Ironman-007/HexSense_Svalbard/README.md

# HexSense_Svalbard

The HexSense sensor node design for Svalbard mission in July, 2023
