Ironman-007/HexSense_Svalbard/Mechanical/bottom_Cap.SLDPRT

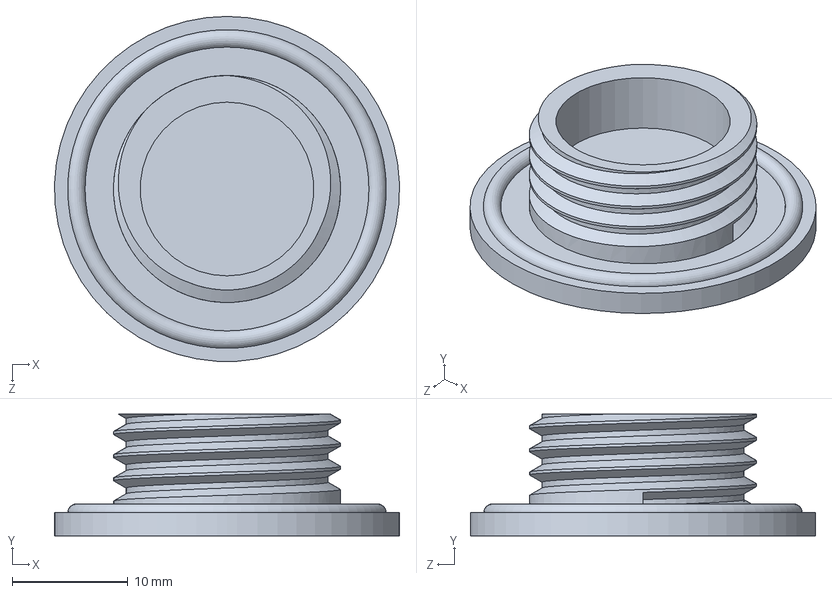
[picture p1: CAD file, 2023-06-30]
Mechanical/bottom_Cap.SLDPRT
29.8 x 10.5 x 29.8 mm
