Ironman-007/HexSense_Svalbard/PCB/Side_PCB.dxf

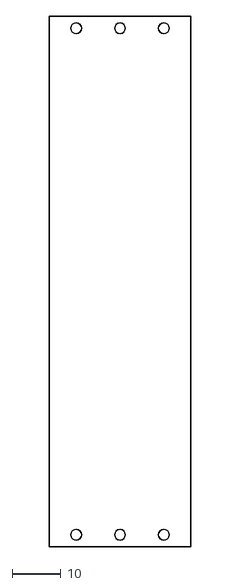
[picture p2: CAD file, 2023-06-01]
PCB/Side_PCB.dxf
29.0 x 109.0
