Ironman-007/HexSense_Svalbard/PCB/TOPBOARD/V1/TOPBOARD.step

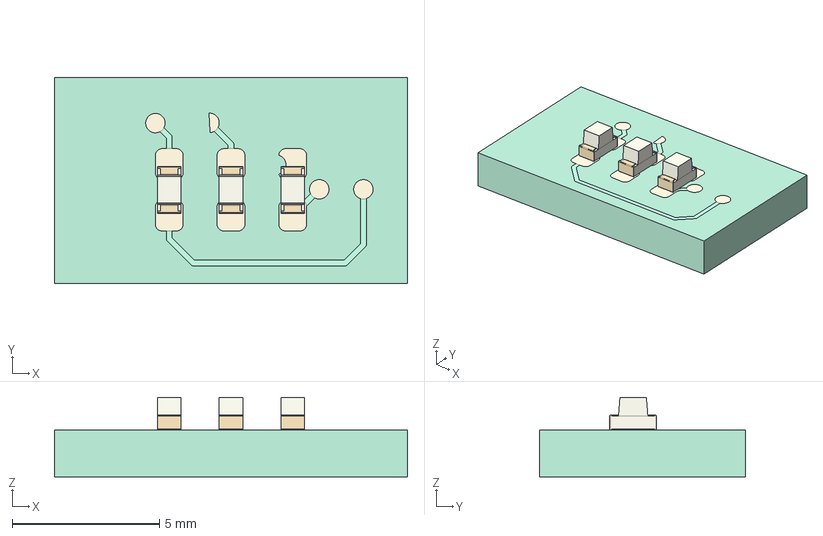
[picture p3: CAD file, 2023-06-09]
PCB/TOPBOARD/V1/TOPBOARD.step
12.0 x 7.00 x 2.72 mm
Local_CS_4601
Pcb_4601
PCB_Sketch_4601
topPads_4601_cut
topTracks_4601
botPads_4601
botTracks_4601
D2_LED_0603_1608Metric_e1ccf86073a2 x 3
