Ironman-007/HexSense_Svalbard/Mechanical/cap.SLDPRT

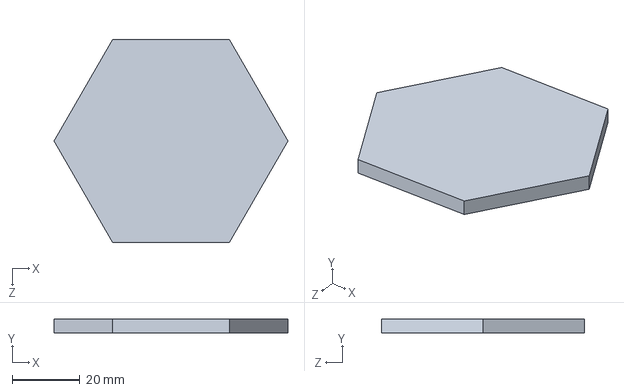
[picture p4: CAD file, 2023-06-30]
Mechanical/cap.SLDPRT
69.3 x 4.00 x 60.0 mm
