Ironman-007/HexSense_Svalbard/PCB/Frame.dxf

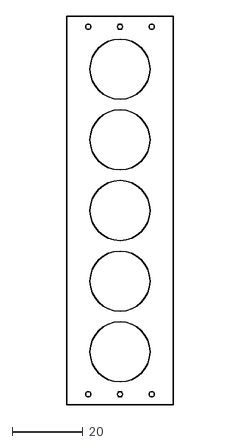
[picture p5: CAD file, 2023-06-01]
PCB/Frame.dxf
30.0 x 110.0
