Ironman-007/HexSense_Svalbard/Mechanical/scharging_port_opner.SLDPRT

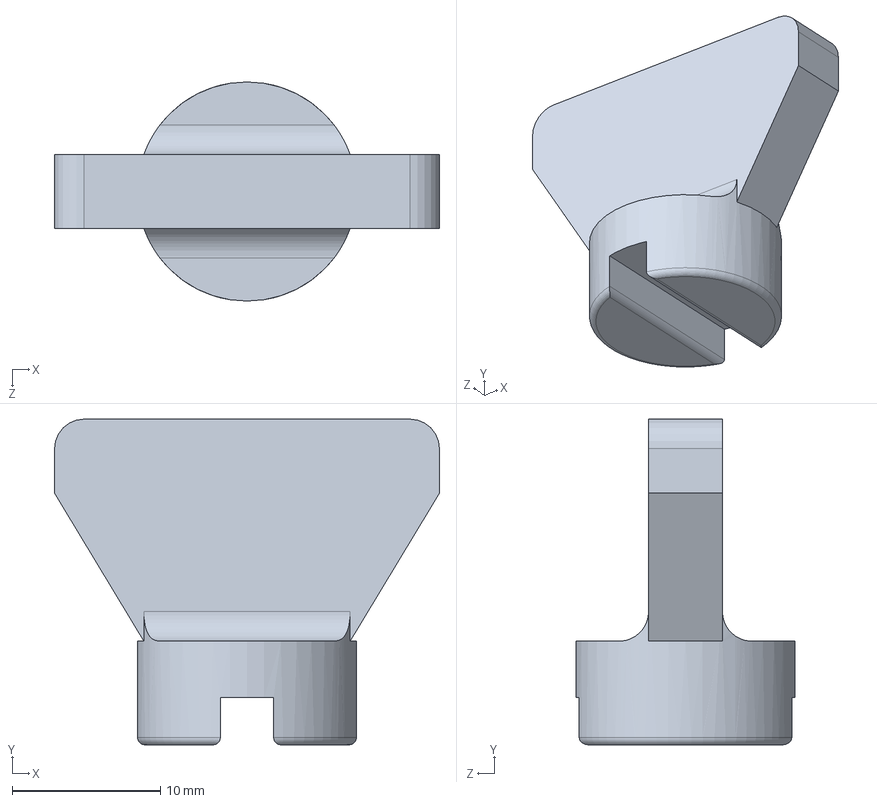
[picture p6: CAD file, 2023-06-30]
Mechanical/scharging_port_opner.SLDPRT
26.0 x 22.0 x 14.8 mm
