Ironman-007/HexSense_Svalbard/PCB/HexSense_Svalbard_internal_PCB_shape.dxf

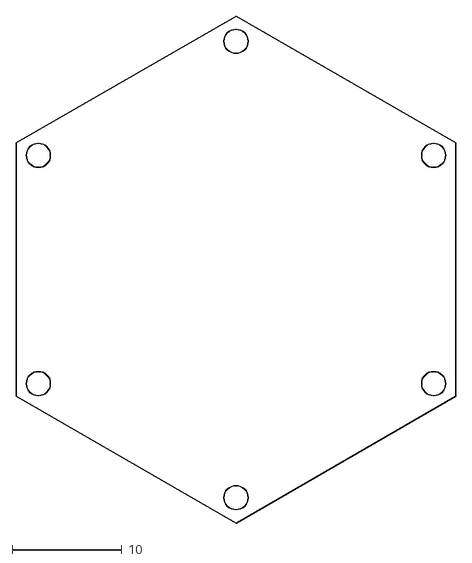
[picture p7: CAD file, 2023-05-29]
PCB/HexSense_Svalbard_internal_PCB_shape.dxf
40.0 x 46.2
