Ironman-007/HexSense_Svalbard/PCB/SIDE/V1/SIDE.step

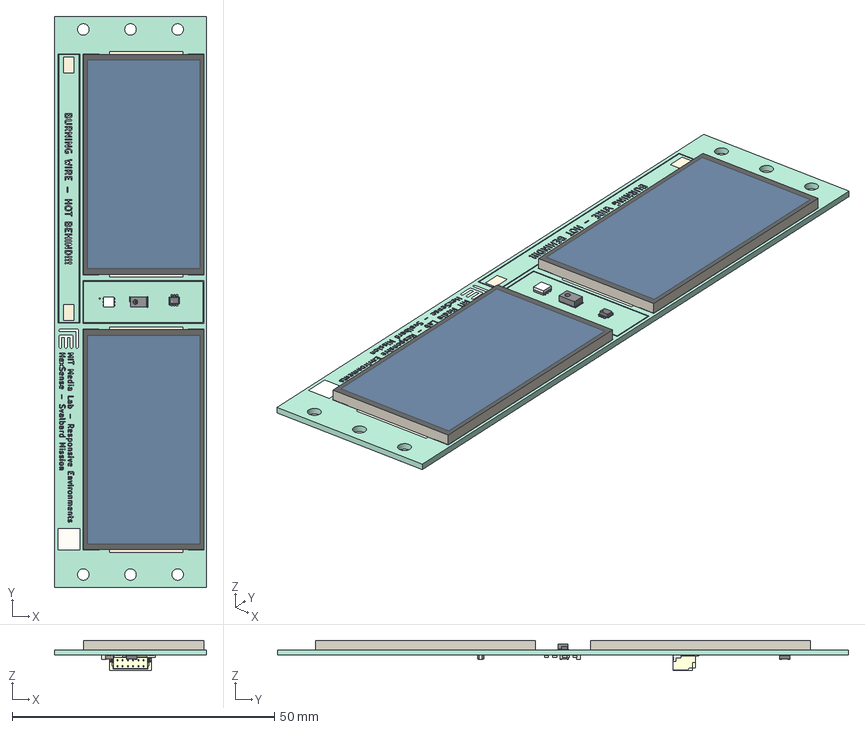
[picture p8: CAD file, 2023-06-01, an earlier design]
PCB/SIDE/V1/SIDE.step
29.0 x 109.0 x 5.76 mm
Local_CS_b4b2
Pcb_b4b2
PCB_Sketch_b4b2
topPads_b4b2_cut
botPads_b4b2
topSilks_87f0
SC2_Part 1_4863a58bc153 x 2
AS7341-DLGT
AS7341-DLGT001
AS7341-DLGT002
AS7341-DLGT003
AS7341-DLGT004
AS7341-DLGT005
AS7341-DLGT006
AS7341-DLGT007
AS7341-DLGT008
AS7341-DLGT009
AS7341-DLGT010
AS7341-DLGT011
AS7341-DLGT012
AS7341-DLGT013
AS7341-DLGT014
AS7341-DLGT015
AS7341-DLGT016
AS7341-DLGT017
AS7341-DLGT018
AS7341-DLGT019
AS7341-DLGT020
AS7341-DLGT021
AS7341-DLGT022
AS7341-DLGT023
AS7341-DLGT024
AS7341-DLGT025
U2_SOT_563_8ebe2970b71a
VEML6030
VEML6031
VEML6032
VEML6033
VEML6034
VEML6035
VEML6036
VEML6037
R5_R_0603_1608Metric_20d752b8e786 x 6
C2_C_0603_1608Metric_8d6b961ed3ee x 2
D1_D_0805_c4761f91ea4f x 2
SM06B-SRSS-TB(LF)(SN)
SM06B-SRSS-TB(LF)(SN)001
SM06B-SRSS-TB(LF)(SN)002
SM06B-SRSS-TB(LF)(SN)003
SM06B-SRSS-TB(LF)(SN)004
SM06B-SRSS-TB(LF)(SN)005
SM06B-SRSS-TB(LF)(SN)006
SM06B-SRSS-TB(LF)(SN)007
SM06B-SRSS-TB(LF)(SN)008
