Ironman-007/HexSense_Svalbard/(list of files, cad)

Other CAD files:
PCB/DATA_STORAGE/V1/DATA_STORAGE-F_Silkscreen.dxf
PCB/DATA_STORAGE/V2/DATA_STORAGE-F_Silkscreen.dxf
PCB/MCU/MCU-F_Silkscreen.dxf
PCB/PWR/V1/PWR-F_Silkscreen.dxf
PCB/PWR/V2/PWR-F_Silkscreen.dxf
PCB/SIDE/V1/SIDE-F_Silkscreen.dxf
PCB/SIDE/V2/SIDE-F_Silkscreen.dxf
PCB/SIDE/V3/SIDE-F_Silkscreen.dxf
