Ironman-007/HexSense_Svalbard/PCB/BURNING_R/V1/BURNING_R.kicad_pcb

## KiCad design PCB/BURNING_R/V1/BURNING_R.kicad_pcb (2023-06-27)

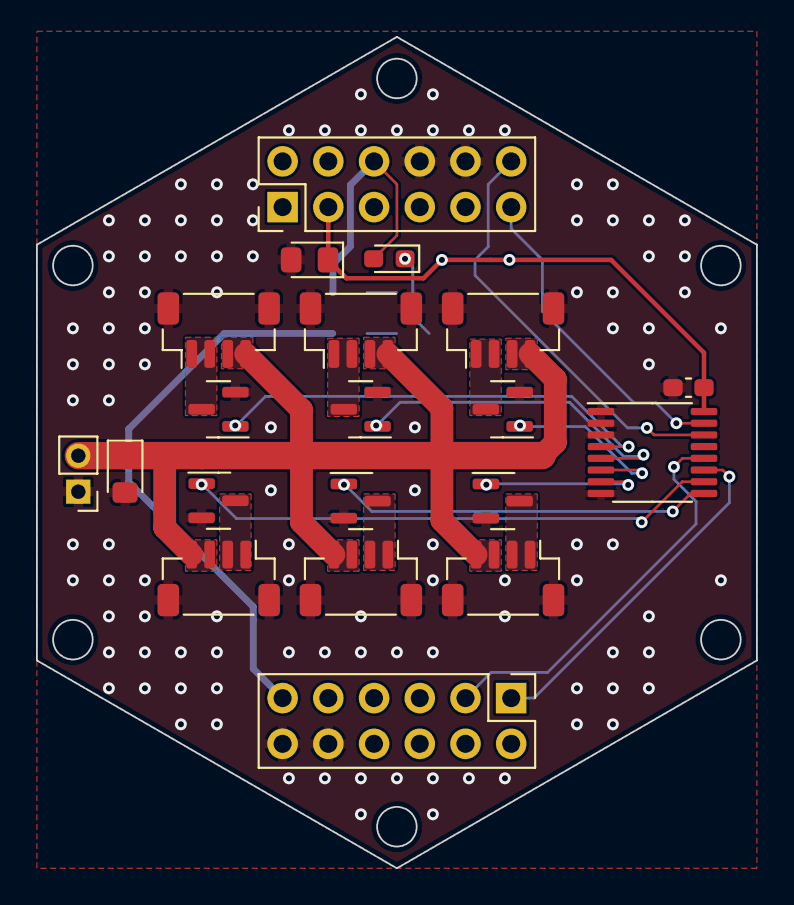
[picture p9: board BURNING_R.kicad_pcb from above]

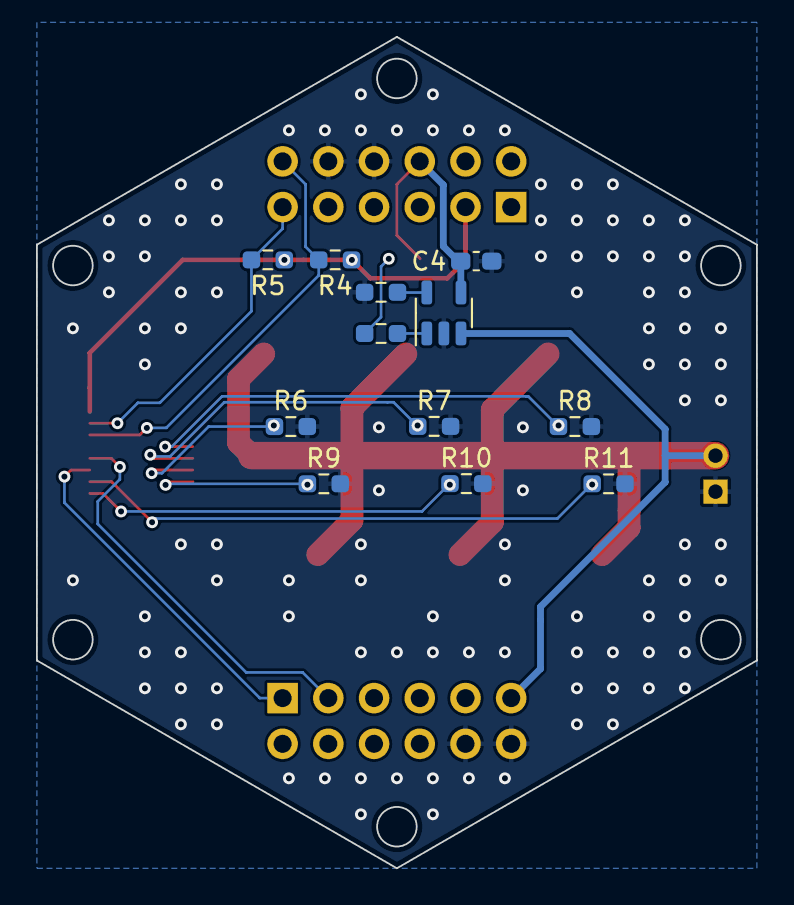
[picture p10: board BURNING_R.kicad_pcb from below]

Board: 2 copper layers, 40.0 x 46.2 mm, 32 parts (12 on the bottom side), 23 nets.

Parts:
C1, C3: 47uF; LED_0805_2012Metric_Pad1.15x1.40mm_HandSolder
C2, C4: 0.1uF; C_0603_1608Metric_Pad1.08x0.95mm_HandSolder
D1: RED; LED_0603_1608Metric_Pad1.05x0.95mm_HandSolder
J1, J2: Conn_02x06_Odd_Even; PinHeader_2x06_P2.54mm_Vertical
J3, J4, J5, J6, J7, J8: BR_conn; JST_SH_BM04B-SRSS-TB_1x04-1MP_P1.00mm_Vertical
J9: Battery; PinHeader_1x02_P2.00mm_Vertical
Q1, Q2, Q3, Q4, Q5, Q6: DMN2056U; SOT-23
R1, R2: 1k; R_0603_1608Metric_Pad0.98x0.95mm_HandSolder
R4, R5: NC; R_0603_1608Metric_Pad0.98x0.95mm_HandSolder
R6, R7, R8, R9, R10, R11: 10k; R_0603_1608Metric_Pad0.98x0.95mm_HandSolder
U1: TCA9534; TSSOP-16_4.4x5mm_P0.65mm
U2: MCP73831-2-OT; SOT-23-5

Connections:
+5V: C4.1, D1.2 (A), J1.6, U2.4 (VDD)
/BAT_BR: C3.1, J2.11, J3.3, J3.4, J4.3, J4.4, J5.3, J5.4, J6.3, J6.4, J7.3, J7.4, J8.3, J8.4, J9.2, U2.3 (VBAT)
/BR_1: J3.1, J3.2, Q1.3 (D)
/BR_1_EN: Q1.1 (G), R11.1, U1.10 (P5)
/BR_2: J4.1, J4.2, Q2.3 (D)
/BR_2_EN: Q2.1 (G), R10.1, U1.9 (P4)
/BR_3: J5.1, J5.2, Q3.3 (D)
/BR_3_EN: Q3.1 (G), R9.1, U1.7 (P3)
/BR_4: J6.1, J6.2, Q4.3 (D)
/BR_4_EN: Q4.1 (G), R8.1, U1.4 (P0)
/BR_5: J7.1, J7.2, Q5.3 (D)
/BR_5_EN: Q5.1 (G), R7.1, U1.5 (P1)
/BR_6: J8.1, J8.2, Q6.3 (D)
/BR_6_EN: Q6.1 (G), R6.1, U1.6 (P2)
/P1: J2.1, U1.11 (P6)
/P2: J2.3, U1.12 (P7)
/SCL: J1.12, R4.2, U1.14 (SCL)
/SDA: J1.11, R5.2, U1.15 (SDA)
GND: C1.2, C2.2, C3.2, C4.2, J1.8, J1.10, J2.10, J2.12, J3.MP, J4.MP, J5.MP, J6.MP, J7.MP, J8.MP, J9.1, Q1.2 (S), Q2.2 (S), Q3.2 (S), Q4.2 (S), Q5.2 (S), Q6.2 (S), R1.1, R6.2, R7.2, R8.2, R9.2, R10.2, R11.2, U1.1 (A0), U1.2 (A1), U1.3 (A2), U1.8 (GND), U2.2 (VSS)
unnamed: D1.1 (K), R2.2
unnamed: R1.2, U2.5 (PROG)
unnamed: R2.1, U2.1 (STAT)
VCC: C1.1, C2.1, J1.3, R4.1, R5.1, U1.16 (VDD)
