Ironman-007/HexSense_Svalbard/PCB/MCU/MCU.kicad_pcb

## KiCad design PCB/MCU/MCU.kicad_pcb (2023-06-27)

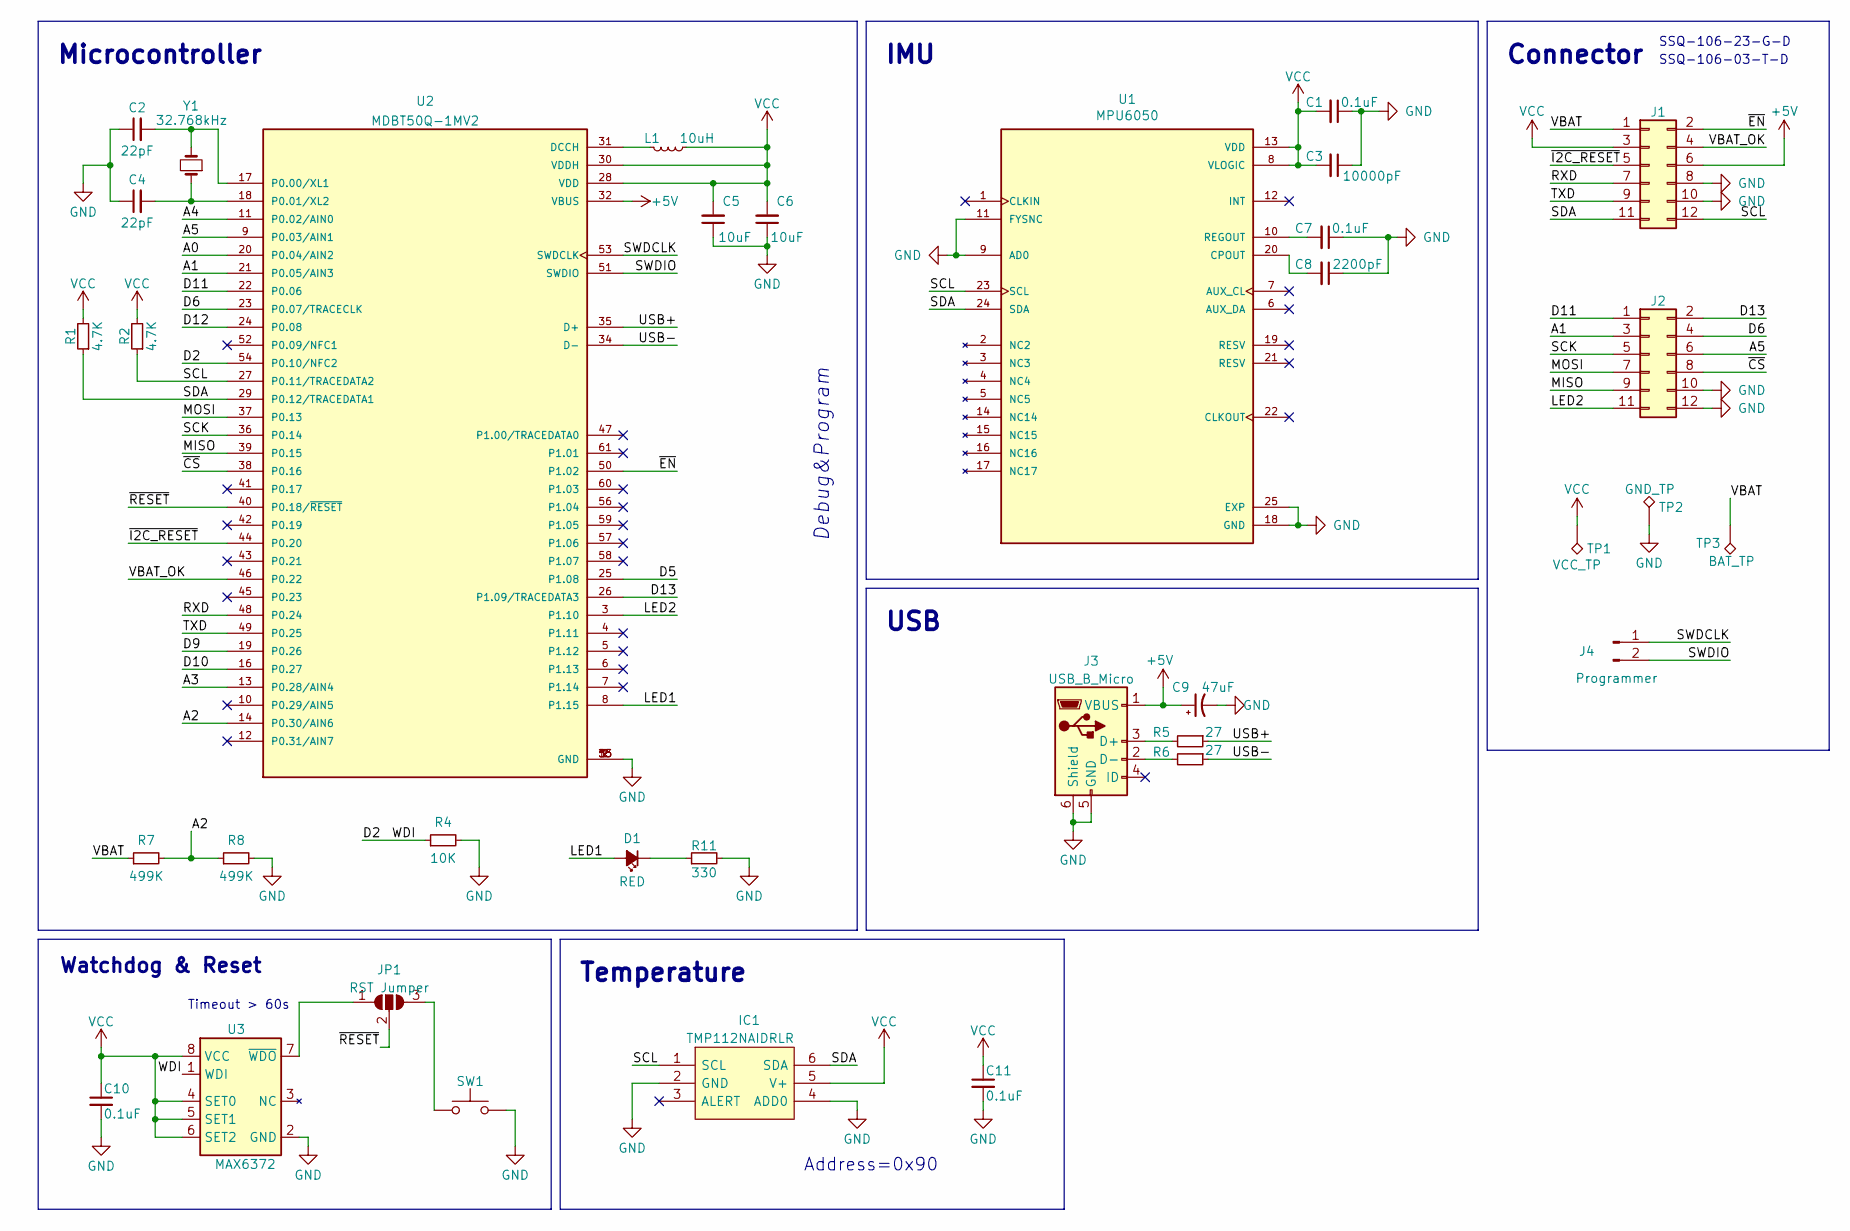
[picture p11: schematic MCU.kicad_sch, HexSense Svalbard - MCU module]

Parts:
C1, C7, C10, C11: 0.1uF; C_0402_1005Metric
C2, C4: 22pF; C_0402_1005Metric_Pad0.74x0.62mm_HandSolder
C3: 10000pF; C_0402_1005Metric
C5, C6: 10uF; C_0402_1005Metric_Pad0.74x0.62mm_HandSolder
C8: 2200pF; C_0402_1005Metric
C9: 47uF; C_0805_2012Metric_Pad1.18x1.45mm_HandSolder
D1: RED; LED_0603_1608Metric_Pad1.05x0.95mm_HandSolder
IC1: TMP112NAIDRLR; SOT50P160X60-6N; Manufacturer_Part_Number TMP112NAIDRLR; Mouser Part Number 595-TMP112NAIDRLR
J1, J2: Conn_02x06_Odd_Even; PinHeader_2x06_P2.54mm_Vertical
J3: USB_B_Micro; USB_Micro-B_Amphenol_10104110_Horizontal
J4: Programmer; PinHeader_1x02_P2.54mm_Vertical
JP1: RST Jumper; SolderJumper-3_P1.3mm_Open_RoundedPad1.0x1.5mm
L1: 10uH; L_0603_1608Metric_Pad1.05x0.95mm_HandSolder
R1, R2: 4.7K; R_0402_1005Metric_Pad0.72x0.64mm_HandSolder
R4: 10K; R_0402_1005Metric
R5, R6: 27; R_0402_1005Metric_Pad0.72x0.64mm_HandSolder
R7, R8: 499K; R_0402_1005Metric_Pad0.72x0.64mm_HandSolder
R11: 330; R_0402_1005Metric_Pad0.72x0.64mm_HandSolder
SW1: SW_Push; SW_Push_1P1T_NO_CK_KMR2
TP1: VCC_TP; TestPoint_Pad_1.5x1.5mm
TP2: GND_TP; TestPoint_Pad_1.5x1.5mm
TP3: BAT_TP; TestPoint_Pad_1.0x1.0mm
U1: MPU6050; IC_MPU6050; PARTREV 3.4
U2: MDBT50Q-1MV2; XCVR_MDBT50Q-1MV2; PARTREV H
U3: MAX6372; SOT-23-8
Y1: 32.768kHz; C_0805_2012Metric_Pad1.18x1.45mm_HandSolder

Connections:
+5V: C9.1, J1.6, J3.1 (VBUS), U2.32 (VBUS)
/A0: U2.20 (P0.04/AIN2)
/A1: J2.3, U2.21 (P0.05/AIN3)
/A2: R7.2, R8.1, U2.14 (P0.30/AIN6)
/A3: U2.13 (P0.28/AIN4)
/A4: U2.11 (P0.02/AIN0)
/A5: J2.6, U2.9 (P0.03/AIN1)
/D2: R4.1, U2.54 (P0.10/NFC2), U3.1 (WDI)
/D5: U2.25 (P1.08)
/D6: J2.4, U2.23 (P0.07/TRACECLK)
/D9: U2.19 (P0.26)
/D10: U2.16 (P0.27)
/D11: J2.1, U2.22 (P0.06)
/D12: U2.24 (P0.08)
/D13: J2.2, U2.26 (P1.09/TRACEDATA3)
/LED1: D1.2 (A), U2.8 (P1.15)
/LED2: J2.11, U2.3 (P1.10)
/MISO: J2.9, U2.39 (P0.15)
/MOSI: J2.7, U2.37 (P0.13)
/RXD: J1.7, U2.48 (P0.24)
/SCK: J2.5, U2.36 (P0.14)
/SCL: IC1.1 (SCL), J1.12, R2.1, U1.23 (SCL), U2.27 (P0.11/TRACEDATA2)
/SDA: IC1.6 (SDA), J1.11, R1.1, U1.24 (SDA), U2.29 (P0.12/TRACEDATA1)
/SWDCLK: J4.1, U2.53 (SWDCLK)
/SWDIO: J4.2, U2.51 (SWDIO)
/TXD: J1.9, U2.49 (P0.25)
/USB+: R5.1, U2.35 (D+)
/USB-: R6.1, U2.34 (D-)
/VBAT: J1.1, R7.1, TP3.1
/VBAT_OK: J1.4, U2.46 (P0.22)
/~CS: J2.8, U2.38 (P0.16)
/~EN: J1.2, U2.50 (P1.02)
/~I2C_RESET: J1.5, U2.44 (P0.20)
/~RESET: JP1.2 (C), U2.40 (P0.18/~RESET)
GND: C1.1, C2.1, C3.1, C4.1, C5.1, C6.1, C7.1, C8.1, C9.2, C10.2, C11.2, IC1.2 (GND), IC1.4 (ADD0), J1.8, J1.10, J2.10, J2.12, J3.5 (GND), J3.6 (Shield), R4.2, R8.2, R11.2, SW1.2, TP2.1, U1.9 (AD0), U1.11 (FYSNC), U1.18 (GND), U1.25 (EXP), U2.1 (GND), U2.2 (GND), U2.15 (GND), U2.33 (GND), U2.55 (GND), U3.2 (GND)
unnamed: D1.1 (K), R11.1
unnamed: J3.3 (D+), R5.2
unnamed: J3.2 (D-), R6.2
unnamed: JP1.1 (A), U3.7 (~WDO)
unnamed: JP1.3 (B), SW1.1
unnamed: C8.2, U1.20 (CPOUT)
unnamed: C7.2, U1.10 (REGOUT)
unnamed: L1.2, U2.31 (DCCH)
unnamed: C2.2, U2.17 (P0.00/XL1), Y1.2
unnamed: C4.2, U2.18 (P0.01/XL2), Y1.1
VCC: C1.2, C3.2, C5.2, C6.2, C10.1, C11.1, IC1.5 (V+), J1.3, L1.1, R1.2, R2.2, TP1.1, U1.8 (VLOGIC), U1.13 (VDD), U2.28 (VDD), U2.30 (VDDH), U3.4 (SET0), U3.5 (SET1), U3.6 (SET2), U3.8 (VCC)

Notes on the sheet:
Debug&Program
IMU
SSQ-106-03-T-D
Microcontroller
Temperature
Timeout > 60s
Watchdog & Reset
USB
Connector
Address=0x90
SSQ-106-23-G-D

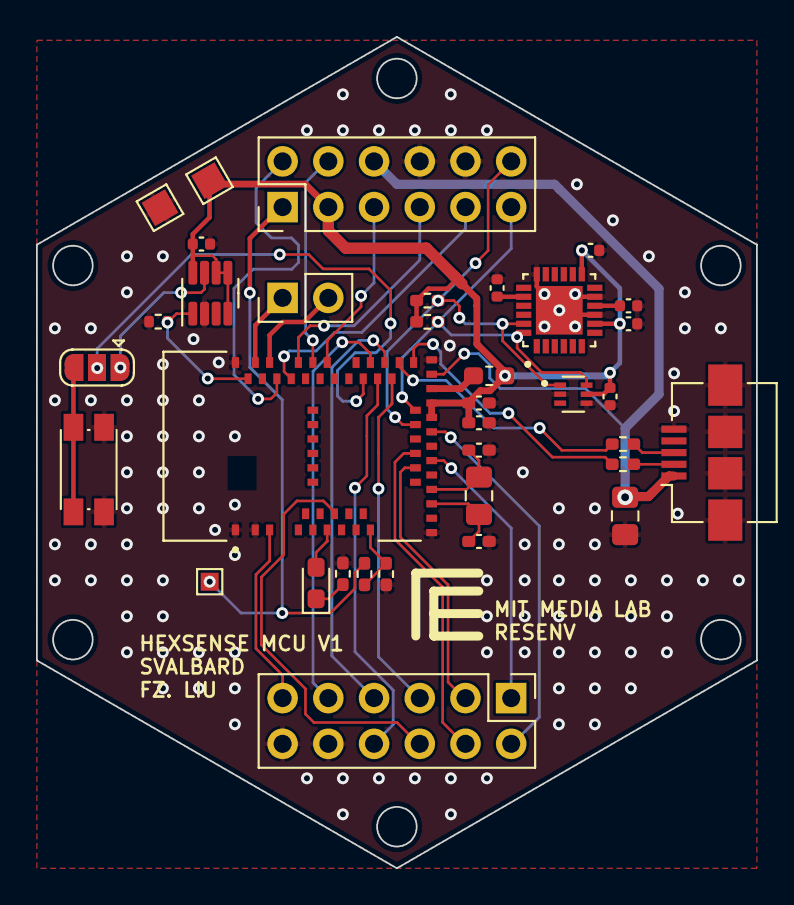
[picture p12: board MCU.kicad_pcb from above]

Board: 2 copper layers, 40.0 x 46.2 mm, 35 parts (0 on the bottom side), 39 nets.
