Ironman-007/HexSense_Svalbard/PCB/DATA_STORAGE/V1/DATA_STORAGE.kicad_pcb

## KiCad design PCB/DATA_STORAGE/V1/DATA_STORAGE.kicad_pcb (2023-06-14, an earlier design)

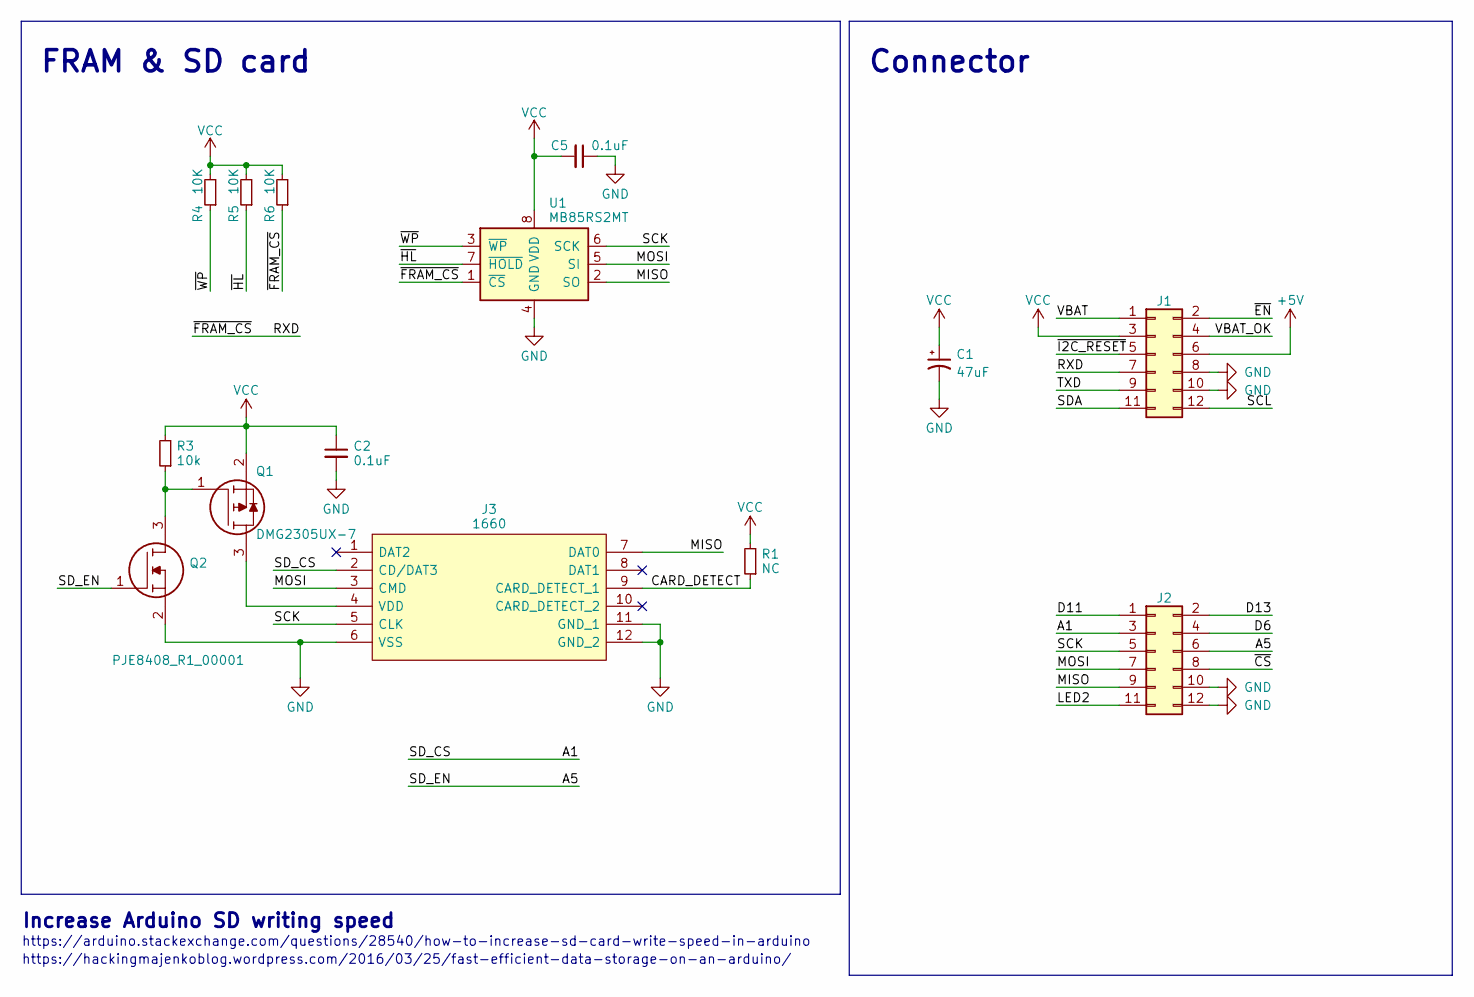
[picture p13: schematic DATA_STORAGE.kicad_sch, HexSense Svalbard - MCU module]

Parts:
C1: 47uF; LED_0805_2012Metric_Pad1.15x1.40mm_HandSolder
C2, C5: 0.1uF; C_0603_1608Metric_Pad1.08x0.95mm_HandSolder
J1, J2: Conn_02x06_Odd_Even; PinHeader_2x06_P2.54mm_Vertical
J3: 1660; Manufacturer_Part_Number 1660; Mouser Part Number 485-1660
Q1: DMG2305UX-7; SOT96P240X110-3N; Manufacturer_Part_Number DMG2305UX-7; Mouser Part Number 621-DMG2305UX-7
Q2: PJE8408_R1_00001; SOTFL50P160X60-3N; Manufacturer_Part_Number PJE8408_R1_00001; Mouser Part Number 241-PJE8408_R1_00001
R1: NC; R_0603_1608Metric_Pad0.98x0.95mm_HandSolder
R3: 10k; R_0603_1608Metric_Pad0.98x0.95mm_HandSolder
R4, R5, R6: 10K; R_0603_1608Metric_Pad0.98x0.95mm_HandSolder
U1: MB85RS2MT; SSOP-8_3.9x5.05mm_P1.27mm

Connections:
+5V: J1.6
/A1: J2.3, J3.2 (CD/DAT3)
/A5: J2.6, Q2.1
/CARD_DETECT: J3.9 (CARD_DETECT_1), R1.1
/D6: J2.4
/D11: J2.1
/D13: J2.2
/LED2: J2.11
/MISO: J2.9, J3.7 (DAT0), U1.2 (SO)
/MOSI: J2.7, J3.3 (CMD), U1.5 (SI)
/RXD: J1.7, R6.1, U1.1 (~CS)
/SCK: J2.5, J3.5 (CLK), U1.6 (SCK)
/SCL: J1.12
/SDA: J1.11
/TXD: J1.9
/VBAT: J1.1
/VBAT_OK: J1.4
/~CS: J2.8
/~EN: J1.2
/~HL: R5.1, U1.7 (~HOLD)
/~I2C_RESET: J1.5
/~WP: R4.1, U1.3 (~WP)
GND: C1.2, C2.2, C5.1, J1.8, J1.10, J2.10, J2.12, J3.6 (VSS), J3.11 (GND_1), J3.12 (GND_2), Q2.2, U1.4 (GND)
unnamed: J3.4 (VDD), Q1.3
unnamed: Q1.1, Q2.3, R3.1
VCC: C1.1, C2.1, C5.2, J1.3, Q1.2, R1.2, R3.2, R4.2, R5.2, R6.2, U1.8 (VDD)

Notes on the sheet:
https://arduino.stackexchange.com/questions/28540/how-to-increase-sd-card-write-speed-in-arduino
FRAM & SD card
Increase Arduino SD writing speed
https://hackingmajenkoblog.wordpress.com/2016/03/25/fast-efficient-data-storage-on-an-arduino/
Connector

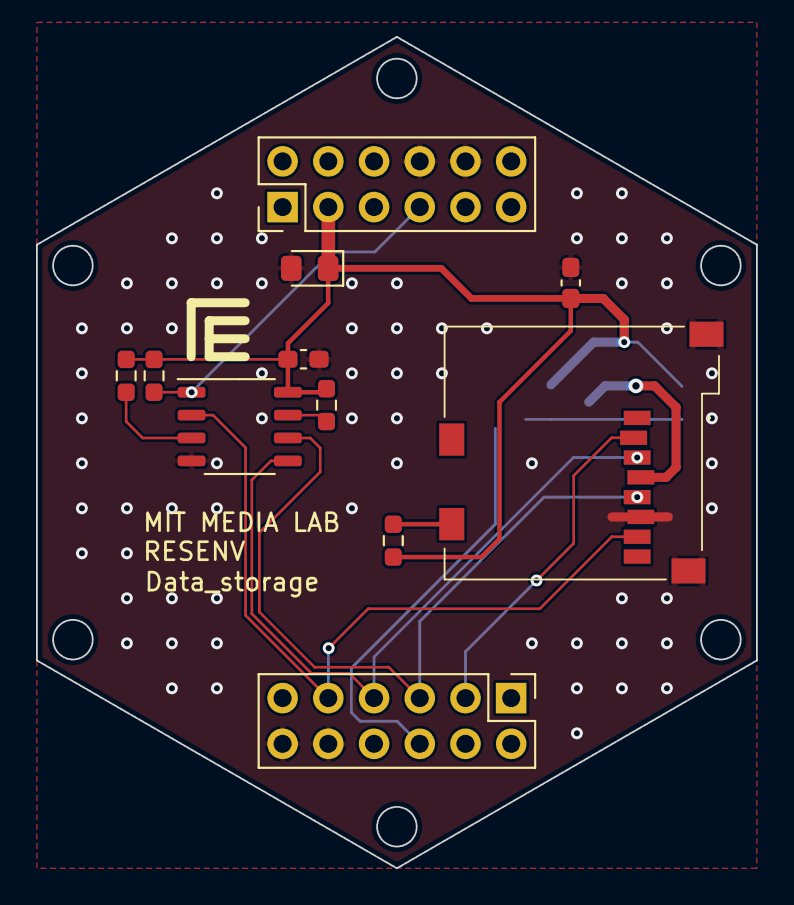
[picture p14: board DATA_STORAGE.kicad_pcb from above]

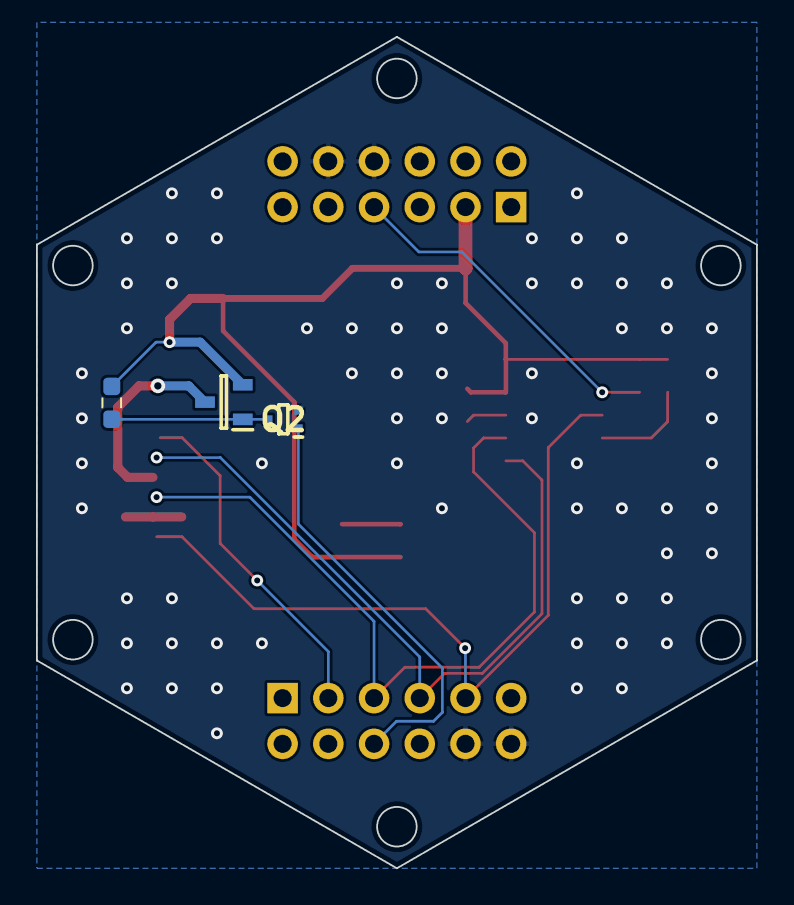
[picture p15: board DATA_STORAGE.kicad_pcb from below]

Board: 2 copper layers, 40.0 x 46.2 mm, 14 parts (3 on the bottom side), 13 nets.
