Ironman-007/HexSense_Svalbard/PCB/CONN/CONN.kicad_pcb

## KiCad design PCB/CONN/CONN.kicad_pcb (2023-06-18)

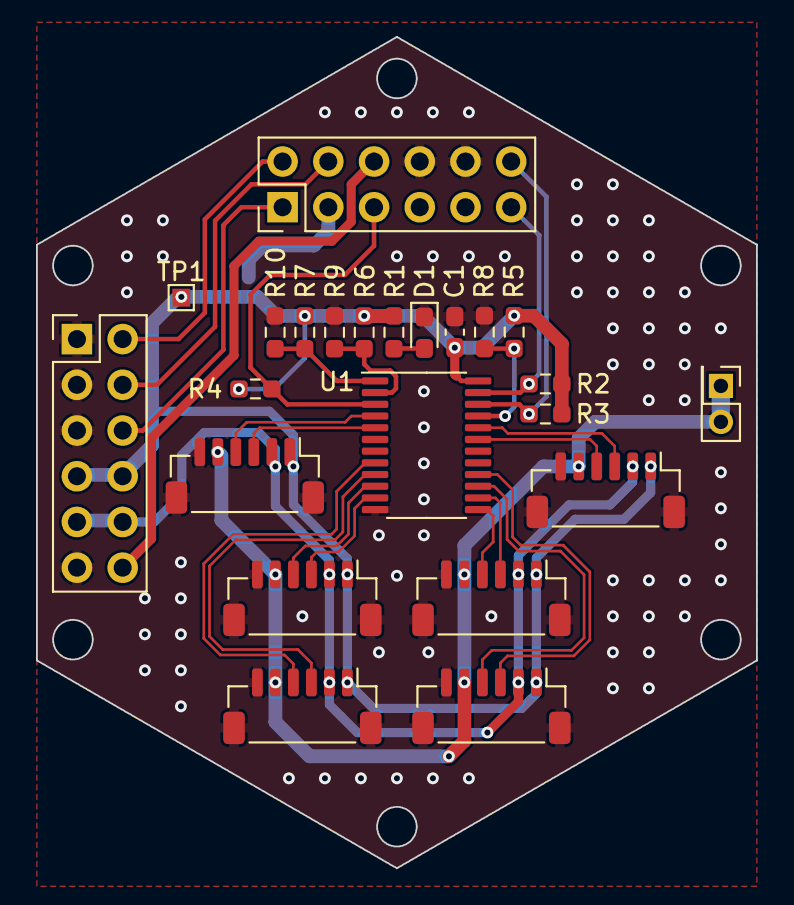
[picture p16: board CONN.kicad_pcb from above]

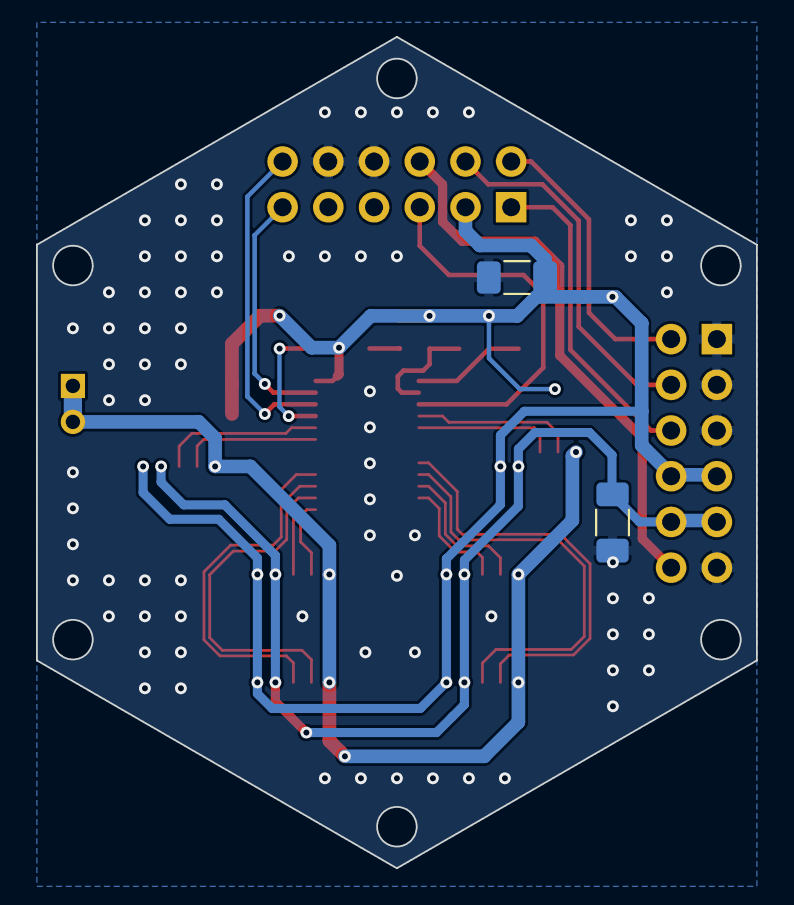
[picture p17: board CONN.kicad_pcb from below]

Board: 2 copper layers, 40.0 x 46.2 mm, 25 parts (2 on the bottom side), 27 nets.

Parts:
C1: 0.1uF; C_0603_1608Metric_Pad1.08x0.95mm_HandSolder
C2, C3: 47uF; C_1206_3216Metric_Pad1.33x1.80mm_HandSolder
D1: RED; LED_0603_1608Metric_Pad1.05x0.95mm_HandSolder
J1, J3: Conn_02x06_Odd_Even; PinHeader_2x06_P2.54mm_Vertical
J2: Solar cell; PinHeader_2x01_P2.00mm_Vertical
J4, J5, J6, J7, J8, J9: BM06B-SURS-TF(LF)(SN); JST_SH_BM06B-SRSS-TB_1x06-1MP_P1.00mm_Vertical
R1, R2, R3: 4.7K; R_0603_1608Metric_Pad0.98x0.95mm_HandSolder
R4, R8, R9, R10: 10k; R_0603_1608Metric_Pad0.98x0.95mm_HandSolder
R5, R6, R7: NC; R_0603_1608Metric_Pad0.98x0.95mm_HandSolder
TP1: TestPoint_Alt; TestPoint_Pad_1.0x1.0mm
U1: TCA9548APWR; TSSOP-24_4.4x7.8mm_P0.65mm

Connections:
+1V8: C3.1, J1.9, J1.10, J4.2, J5.2, J6.2, J7.2, J8.2, J9.2
+3V3: C1.1, C2.1, J1.7, J1.8, J3.3, J4.1, J5.1, J6.1, J7.1, J8.1, J9.1, R1.2, R2.2, R3.2, R4.2, R5.2, R6.2, R7.2, TP1.1, U1.24 (VCC)
+5V: J1.12, J3.6
/SC: J2.1, J2.2, J4.5, J5.5, J6.5, J7.5, J8.5, J9.5
/SCL: J3.12, R3.1, U1.22 (SCL)
/SCL0: J6.3, U1.5 (SC0)
/SCL2: J4.3, U1.9 (SC2)
/SCL3: J7.3, U1.11 (SC3)
/SCL4: J5.3, U1.14 (SC4)
/SCL5: J9.3, U1.16 (SC5)
/SCL7: J8.3, U1.20 (SC7)
/SDA: J3.11, R2.1, U1.23 (SDA)
/SDA0: J6.4, U1.4 (SD0)
/SDA2: J4.4, U1.8 (SD2)
/SDA3: J7.4, U1.10 (SD3)
/SDA4: J5.4, U1.13 (SD4)
/SDA5: J9.4, U1.15 (SD5)
/SDA7: J8.4, U1.19 (SD7)
/VBAT: J1.6, J3.1
/VBAT_OK: J1.4, J3.4
/~EN: J1.2, J3.2
/~RESET: J3.5, R4.1, U1.3 (~RESET)
GND: C1.2, C2.2, C3.2, D1.1 (K), J1.1, J1.3, J1.5, J1.11, J3.8, J3.10, J4.6, J4.MP, J5.6, J5.MP, J6.6, J6.MP, J7.6, J7.MP, J8.6, J8.MP, J9.6, J9.MP, R8.1, R9.1, R10.1, U1.12 (GND)
unnamed: D1.2 (A), R1.1
unnamed: R5.1, R8.2, U1.21 (A2)
unnamed: R6.1, R9.2, U1.2 (A1)
unnamed: R7.1, R10.2, U1.1 (A0)
