Ironman-007/HexSense_Svalbard/PCB/PWR/V2/PWR.kicad_pcb

## KiCad design PCB/PWR/V2/PWR.kicad_pcb (2023-06-14)

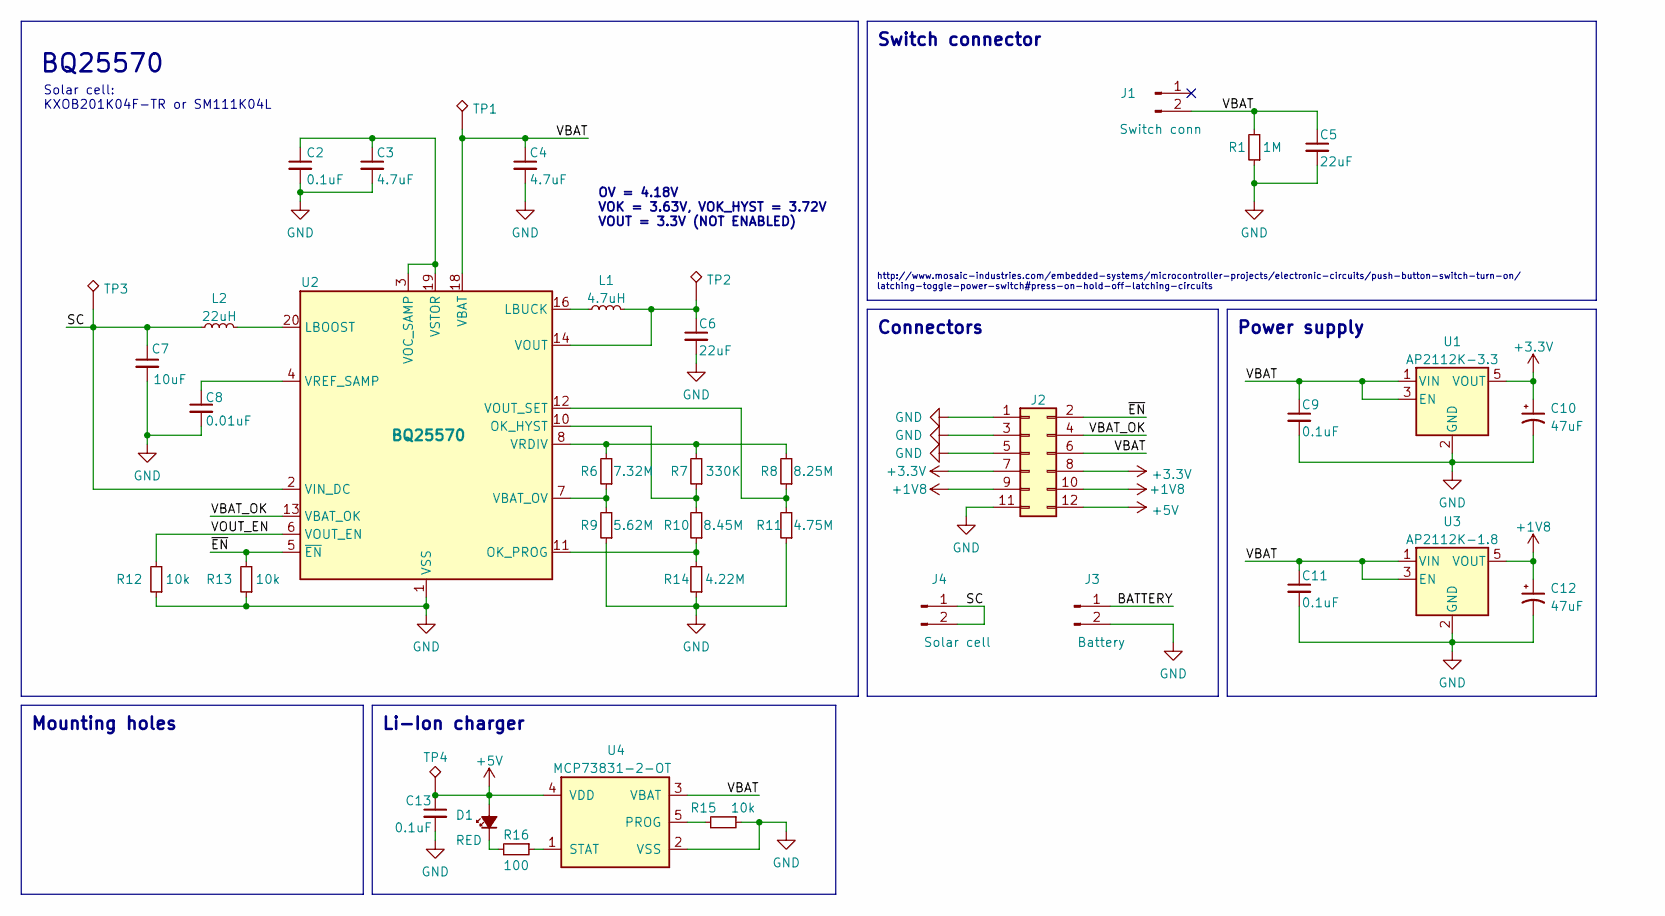
[picture p18: schematic PWR.kicad_sch, HexSense Svalbard - PWR]

Parts:
C2, C9, C11, C13: 0.1uF; C_0402_1005Metric_Pad0.74x0.62mm_HandSolder
C3, C4: 4.7uF; C_0603_1608Metric_Pad1.08x0.95mm_HandSolder
C5: 22uF; C_1206_3216Metric_Pad1.33x1.80mm_HandSolder
C6: 22uF; C_0805_2012Metric_Pad1.18x1.45mm_HandSolder
C7: 10uF; C_0603_1608Metric_Pad1.08x0.95mm_HandSolder
C8: 0.01uF; C_0402_1005Metric_Pad0.74x0.62mm_HandSolder
C10, C12: 47uF; LED_0805_2012Metric_Pad1.15x1.40mm_HandSolder
D1: RED; LED_0603_1608Metric_Pad1.05x0.95mm_HandSolder
J1: Switch conn; PinHeader_1x02_P2.54mm_Vertical
J2: Conn_02x06_Odd_Even; PinHeader_2x06_P2.54mm_Vertical
J3: Battery; PinHeader_2x01_P2.00mm_Vertical
J4: Solar cell; PinHeader_2x01_P2.00mm_Vertical
L1: 4.7uH; L_Wuerth_MAPI-3015
L2: 22uH; L_Taiyo-Yuden_NR-40xx_HandSoldering
R1: 1M; R_1206_3216Metric_Pad1.30x1.75mm_HandSolder
R6: 7.32M; R_0603_1608Metric_Pad0.98x0.95mm_HandSolder
R7: 330K; R_0603_1608Metric_Pad0.98x0.95mm_HandSolder
R8: 8.25M; R_0603_1608Metric_Pad0.98x0.95mm_HandSolder
R9: 5.62M; R_0603_1608Metric_Pad0.98x0.95mm_HandSolder
R10: 8.45M; R_0603_1608Metric_Pad0.98x0.95mm_HandSolder
R11: 4.75M; R_0603_1608Metric_Pad0.98x0.95mm_HandSolder
R12, R13, R15: 10k; R_0603_1608Metric_Pad0.98x0.95mm_HandSolder
R14: 4.22M; R_0603_1608Metric_Pad0.98x0.95mm_HandSolder
R16: 100; R_0603_1608Metric_Pad0.98x0.95mm_HandSolder
TP1, TP2, TP3, TP4: TestPoint_Alt; TestPoint_Pad_1.0x1.0mm
U1: AP2112K-3.3; SOT-23-5
U2: BQ25570; QFN-20-1EP_3.5x3.5mm_P0.5mm_EP2x2mm
U3: AP2112K-1.8; SOT-23-5
U4: MCP73831-2-OT; SOT-23-5

Connections:
+1V8: C12.1, J2.9, J2.10, U3.5 (VOUT)
+3V3: C10.1, J2.7, J2.8, U1.5 (VOUT)
+5V: C13.1, D1.2 (A), J2.12, TP4.1, U4.4 (VDD)
/BATTERY: J3.1
/SC: C7.1, J4.1, J4.2, L2.1, TP3.1, U2.2 (VIN_DC)
/VBAT: C4.1, C5.1, C9.1, C11.1, J1.2, J2.6, R1.2, TP1.1, U1.1 (VIN), U1.3 (EN), U2.18 (VBAT), U3.1 (VIN), U3.3 (EN), U4.3 (VBAT)
/VBAT_OK: J2.4, U2.13 (VBAT_OK)
/VOUT_EN: R12.2, U2.6 (VOUT_EN)
/~EN: J2.2, R13.2, U2.5 (~EN)
GND: C2.2, C3.2, C4.2, C5.2, C6.2, C7.2, C8.2, C9.2, C10.2, C11.2, C12.2, C13.2, J2.1, J2.3, J2.5, J2.11, J3.2, R1.1, R9.1, R11.1, R12.1, R13.1, R14.1, R15.1, U1.2 (GND), U2.1 (VSS), U2.9 (VSS), U2.15 (VSS), U2.17 (VSS), U2.21 (VSS), U3.2 (GND), U4.2 (VSS)
unnamed: D1.1 (K), R16.2
unnamed: L2.2, U2.20 (LBOOST)
unnamed: L1.1, U2.16 (LBUCK)
unnamed: R7.1, R10.2, U2.10 (OK_HYST)
unnamed: R10.1, R14.2, U2.11 (OK_PROG)
unnamed: R6.1, R9.2, U2.7 (VBAT_OV)
unnamed: C2.1, C3.1, U2.3 (VOC_SAMP), U2.19 (VSTOR)
unnamed: C6.1, L1.2, TP2.1, U2.14 (VOUT)
unnamed: R8.1, R11.2, U2.12 (VOUT_SET)
unnamed: R6.2, R7.2, R8.2, U2.8 (VRDIV)
unnamed: C8.1, U2.4 (VREF_SAMP)
unnamed: R15.2, U4.5 (PROG)
unnamed: R16.1, U4.1 (STAT)

Notes on the sheet:
Li-Ion charger
BQ25570
Switch connector
Mounting holes
Solar cell: KXOB201K04F-TR or SM111K04L
OV = 4.18V VOK = 3.63V, VOK_HYST = 3.72V VOUT = 3.3V (NOT ENABLED)
Power supply
http://www.mosaic-industries.com/embedded-systems/microcontroller-projects/electronic-circuits/push-button-switch-turn-on/ latching-toggle-power-switch#press-on-hold-off-latching-circuits
Connectors

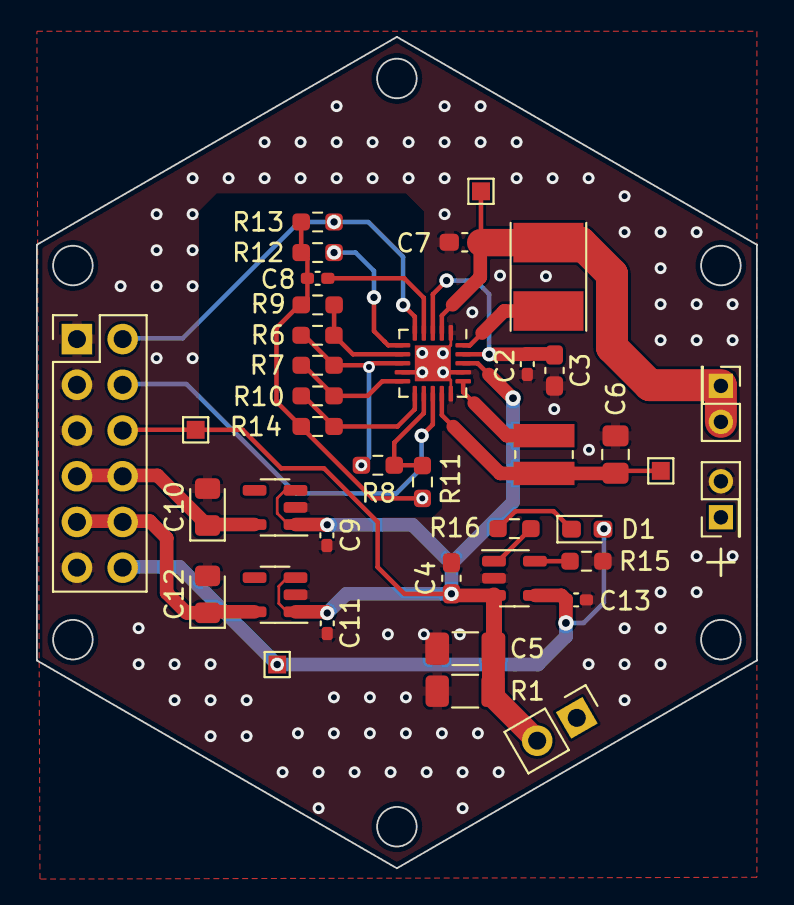
[picture p19: board PWR.kicad_pcb from above]

Board: 2 copper layers, 40.0 x 46.2 mm, 39 parts (0 on the bottom side), 22 nets.
