Ironman-007/HexSense_Svalbard/PCB/INDICATOR/V1/INDICATOR.kicad_pcb

## KiCad design PCB/INDICATOR/V1/INDICATOR.kicad_pcb (2023-06-09)

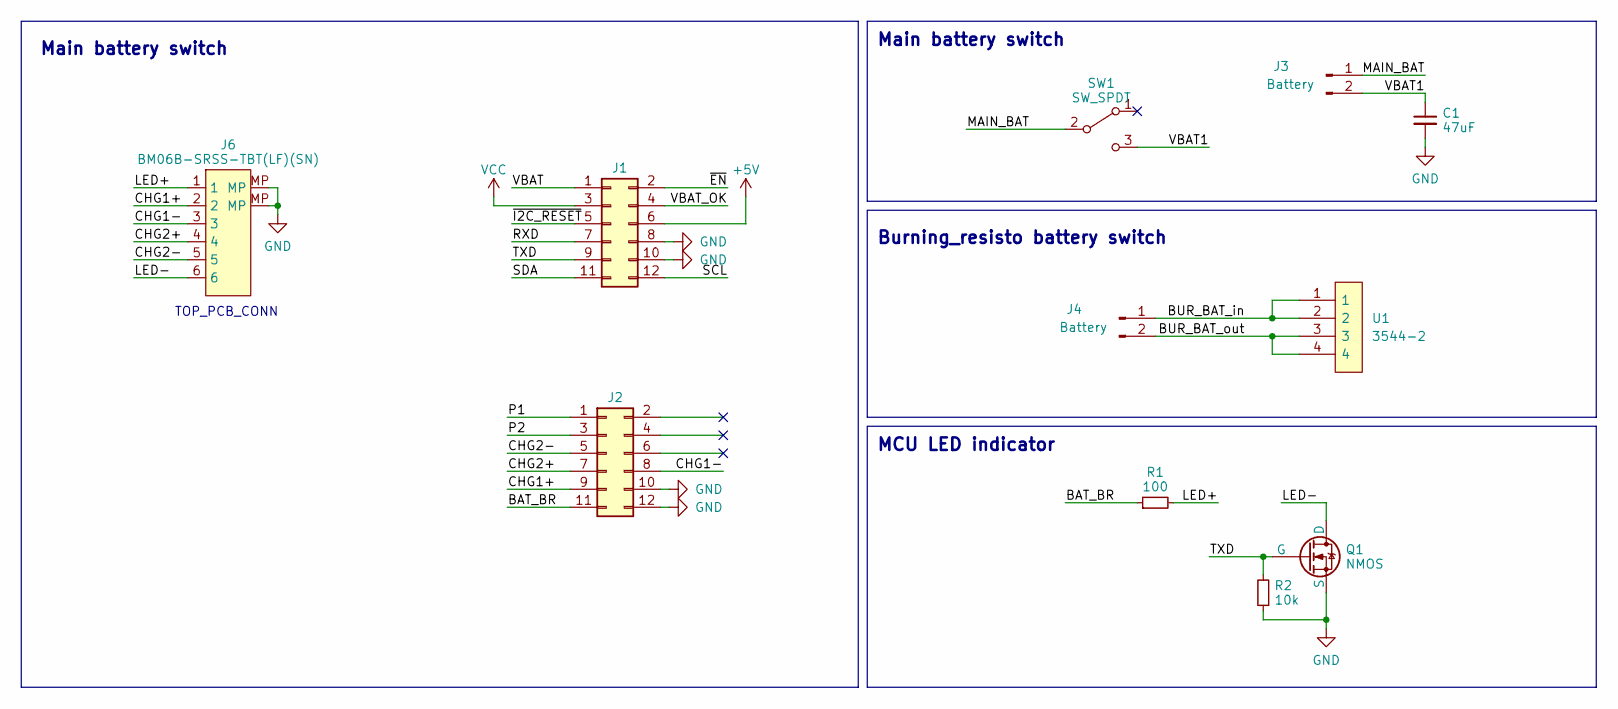
[picture p20: schematic INDICATOR.kicad_sch, HexSense Svalbard - PWR]

Parts:
C1: 47uF; CP_EIA-6032-15_Kemet-U_Pad2.25x2.35mm_HandSolder
J1, J2: Conn_02x06_Odd_Even; PinHeader_2x06_P2.54mm_Vertical
J3, J4: Battery; PinHeader_2x01_P2.00mm_Vertical
J6: BM06B-SRSS-TBT(LF)(SN); JST_SH_BM06B-SRSS-TB_1x06-1MP_P1.00mm_Vertical
Q1: NMOS; SOT-23
R1: 100; R_0603_1608Metric_Pad0.98x0.95mm_HandSolder
R2: 10k; R_0603_1608Metric_Pad0.98x0.95mm_HandSolder
SW1: SW_SPDT; PinHeader_1x03_P2.54mm_Vertical
U1: 3544-2; Manufacturer_Part_Number 3544-2; Mouser Part Number 534-3544-2

Connections:
+5V: J1.6
/BAT_BR: J2.11, R1.1
/BUR_BAT_in: J4.1, U1.1, U1.2
/BUR_BAT_out: J4.2, U1.3, U1.4
/CHG1+: J2.9, J6.2
/CHG1-: J2.8, J6.3
/CHG2+: J2.7, J6.4
/CHG2-: J2.5, J6.5
/LED+: J6.1, R1.2
/LED-: J6.6, Q1.1 (D)
/MAIN_BAT: J3.1, SW1.2 (B)
/P1: J2.1
/P2: J2.3
/RXD: J1.7
/SCL: J1.12
/SDA: J1.11
/TXD: J1.9, Q1.2 (G), R2.2
/VBAT: J1.1
/VBAT1: C1.1, J3.2, SW1.3 (C)
/VBAT_OK: J1.4
/~EN: J1.2
/~I2C_RESET: J1.5
GND: C1.2, J1.8, J1.10, J2.10, J2.12, J6.MP, Q1.3 (S), R2.1
VCC: J1.3

Notes on the sheet:
Main battery switch
Burning_resisto battery switch
MCU LED indicator
TOP_PCB_CONN

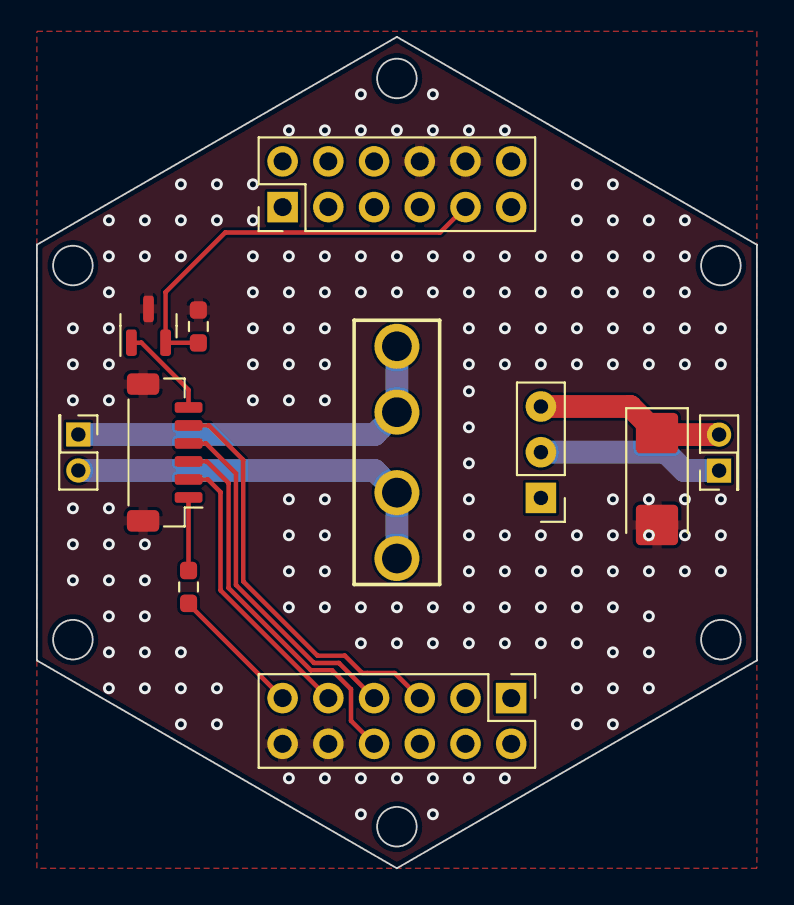
[picture p21: board INDICATOR.kicad_pcb from above]

Board: 2 copper layers, 40.0 x 46.2 mm, 11 parts (0 on the bottom side), 13 nets.
