Ironman-007/HexSense_Svalbard/PCB/TOPBOARD/V1/TOPBOARD.kicad_pcb

## KiCad design PCB/TOPBOARD/V1/TOPBOARD.kicad_pcb (2023-06-09)

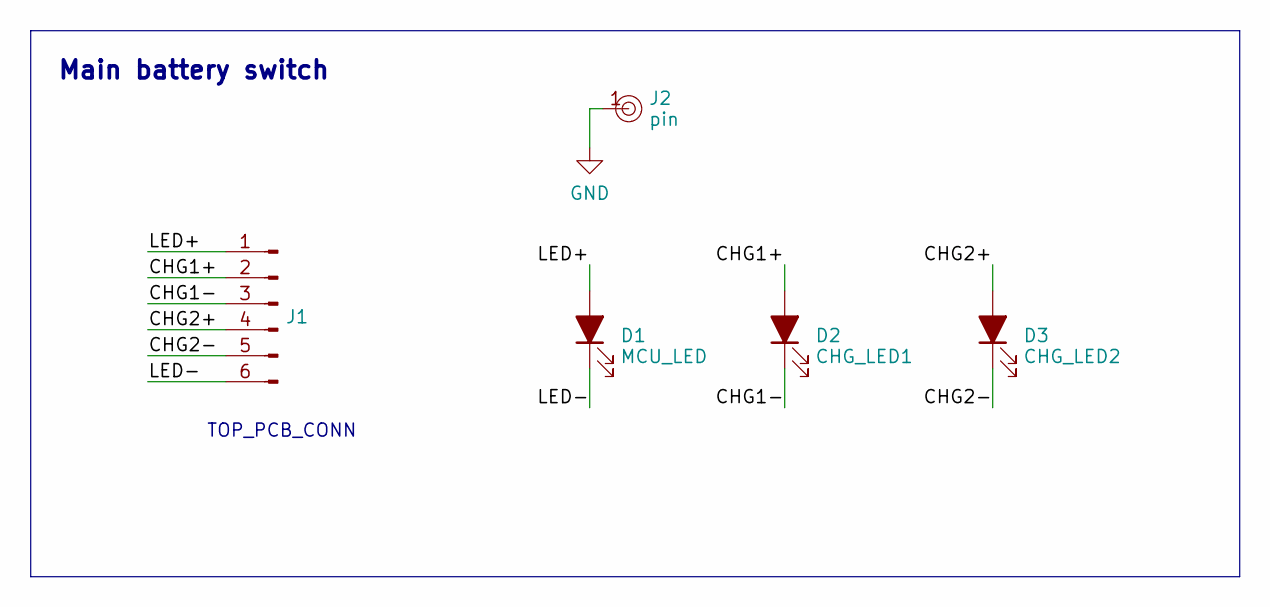
[picture p22: schematic TOPBOARD.kicad_sch, HexSense Svalbard - PWR]

Parts:
D1: MCU_LED; LED_0603_1608Metric_Pad1.05x0.95mm_HandSolder
D2: CHG_LED1; LED_0603_1608Metric_Pad1.05x0.95mm_HandSolder
D3: CHG_LED2; LED_0603_1608Metric_Pad1.05x0.95mm_HandSolder
J1: Conn_01x06_Pin; FZ_SMD_01x06_2.00mm
J2: pin; 1_pin_SMD_1.5mmx1.0mm

Connections:
/CHG1+: D2.2 (A), J1.2
/CHG1-: D2.1 (K), J1.3
/CHG2+: D3.2 (A), J1.4
/CHG2-: D3.1 (K), J1.5
/LED+: D1.2 (A), J1.1
/LED-: D1.1 (K), J1.6
GND: J2.1

Notes on the sheet:
Main battery switch
TOP_PCB_CONN

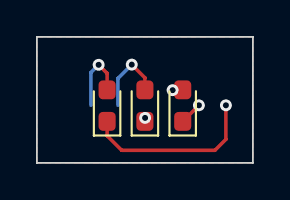
[picture p23: board TOPBOARD.kicad_pcb from above]

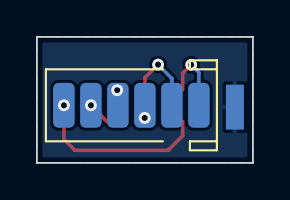
[picture p24: board TOPBOARD.kicad_pcb from below]

Board: 2 copper layers, 12.0 x 7.0 mm, 5 parts (2 on the bottom side), 6 nets.
