Ironman-007/HexSense_Svalbard/PCB/SIDE/V3/SIDE.kicad_pcb

## KiCad design PCB/SIDE/V3/SIDE.kicad_pcb (2023-06-09)

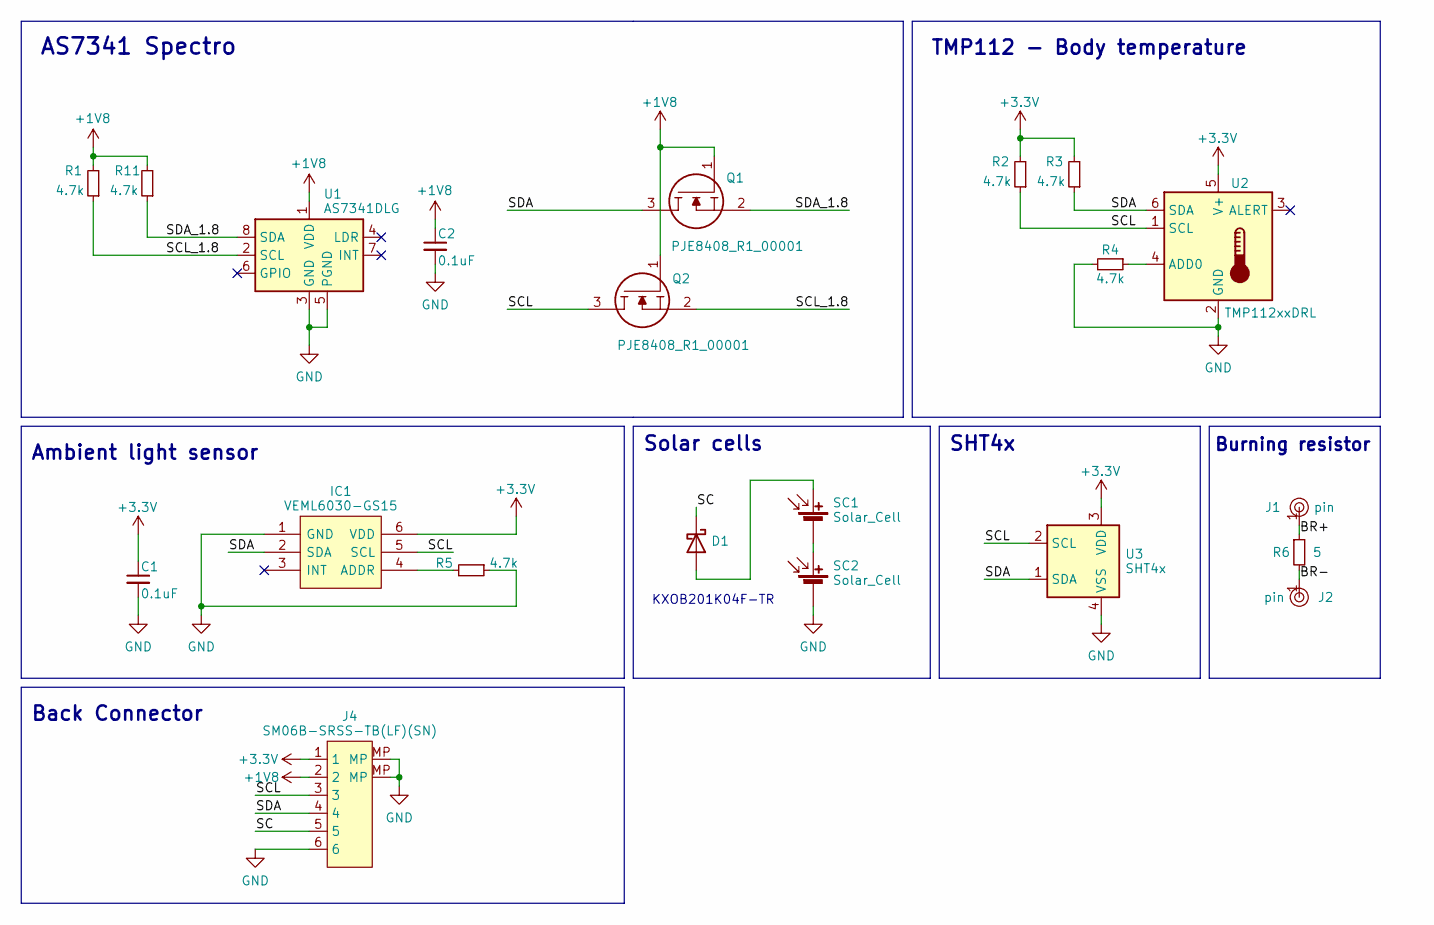
[picture p25: schematic SIDE.kicad_sch, HexSense Svalbard SIDE module]

Parts:
C1, C2: 0.1uF; C_0603_1608Metric_Pad1.08x0.95mm_HandSolder
D1: D_Schottky; D_0805_2012Metric_Pad1.15x1.40mm_HandSolder
IC1: VEML6030-GS15; VEML6030GS15; Manufacturer_Part_Number VEML6030-GS15; Mouser Part Number 78-VEML6030-GS15
J1, J2: pin; 1_pin_SMD_1mmx1mm
J4: SM06B-SRSS-TB(LF)(SN); JST_SH_SM06B-SRSS-TB_1x06-1MP_P1.00mm_Horizontal
Q1, Q2: PJE8408_R1_00001; SOTFL50P160X60-3N; Manufacturer_Part_Number PJE8408_R1_00001; Mouser Part Number 241-PJE8408_R1_00001
R1, R2, R3, R4, R5, R11: 4.7k; R_0603_1608Metric_Pad0.98x0.95mm_HandSolder
R6: 5; R_Axial_DIN0207_L6.3mm_D2.5mm_P10.16mm_Horizontal
SC1, SC2: Solar_Cell; KXOB201K04F-TR
U1: AS7341DLG; AMS_OLGA-8_2x3.1mm_P0.8mm
U2: TMP112xxDRL; SOT-563
U3: SHT4x; Sensirion_DFN-4_1.5x1.5mm_P0.8mm_SHT4x_NoCentralPad

Connections:
+1V8: C2.1, J4.2, Q1.1, Q2.1, R1.2, R11.2, U1.1 (VDD)
+3V3: C1.1, IC1.6 (VDD), J4.1, R2.2, R3.2, U2.5 (V+), U3.3 (VDD)
/BR+: J1.1, R6.1
/BR-: J2.1, R6.2
/SC: D1.1 (K), J4.5
/SCL: IC1.5 (SCL), J4.3, Q2.3, R2.1, U2.1 (SCL), U3.2 (SCL)
/SCL_1.8: Q2.2, R1.1, U1.2 (SCL)
/SDA: IC1.2 (SDA), J4.4, Q1.3, R3.1, U2.6 (SDA), U3.1 (SDA)
/SDA_1.8: Q1.2, R11.1, U1.8 (SDA)
GND: C1.2, C2.2, IC1.1 (GND), J4.6, J4.MP, R4.2, R5.1, SC2.2 (-), U1.3 (GND), U1.5 (PGND), U2.2 (GND), U3.4 (VSS)
unnamed: D1.2 (A), SC1.1 (+)
unnamed: IC1.4 (ADDR), R5.2
unnamed: SC1.2 (-), SC2.1 (+)
unnamed: R4.1, U2.4 (ADD0)

Notes on the sheet:
Burning resistor
Back Connector
TMP112 - Body temperature
KXOB201K04F-TR
Solar cells
SHT4x
AS7341 Spectro
Ambient light sensor

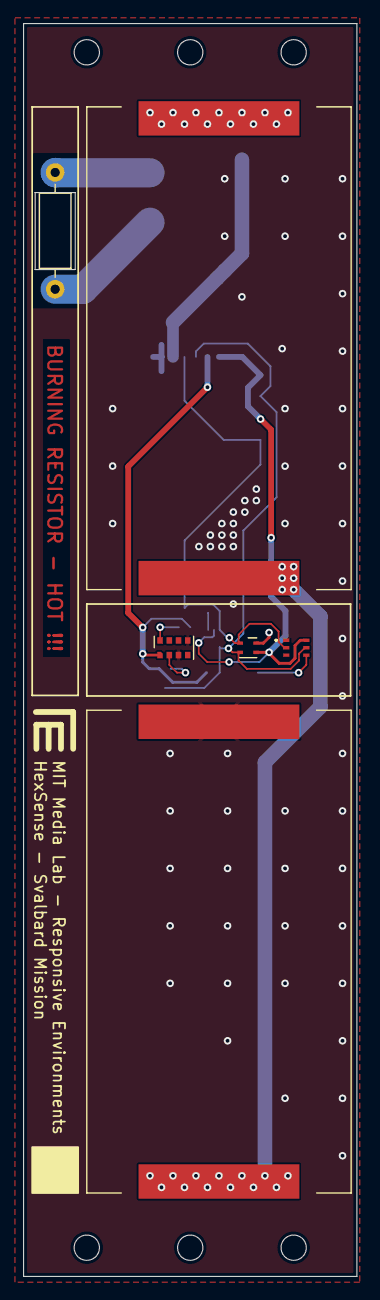
[picture p26: board SIDE.kicad_pcb from above]

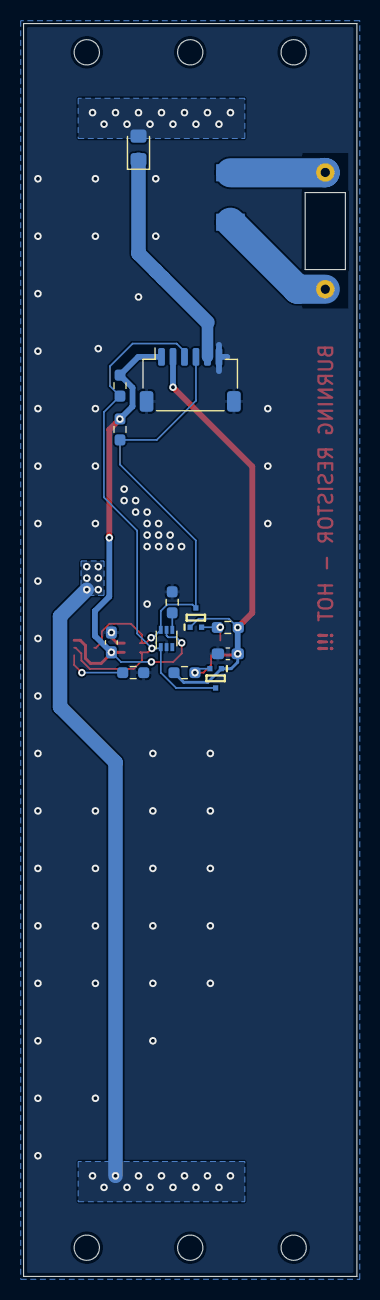
[picture p27: board SIDE.kicad_pcb from below]

Board: 2 copper layers, 29.0 x 109.0 mm, 21 parts (15 on the bottom side), 14 nets.
