Ironman-007/HexSense_Svalbard/PCB/ADXL355/ADXL355.kicad_pcb

## KiCad design PCB/ADXL355/ADXL355.kicad_pcb (2023-06-01)

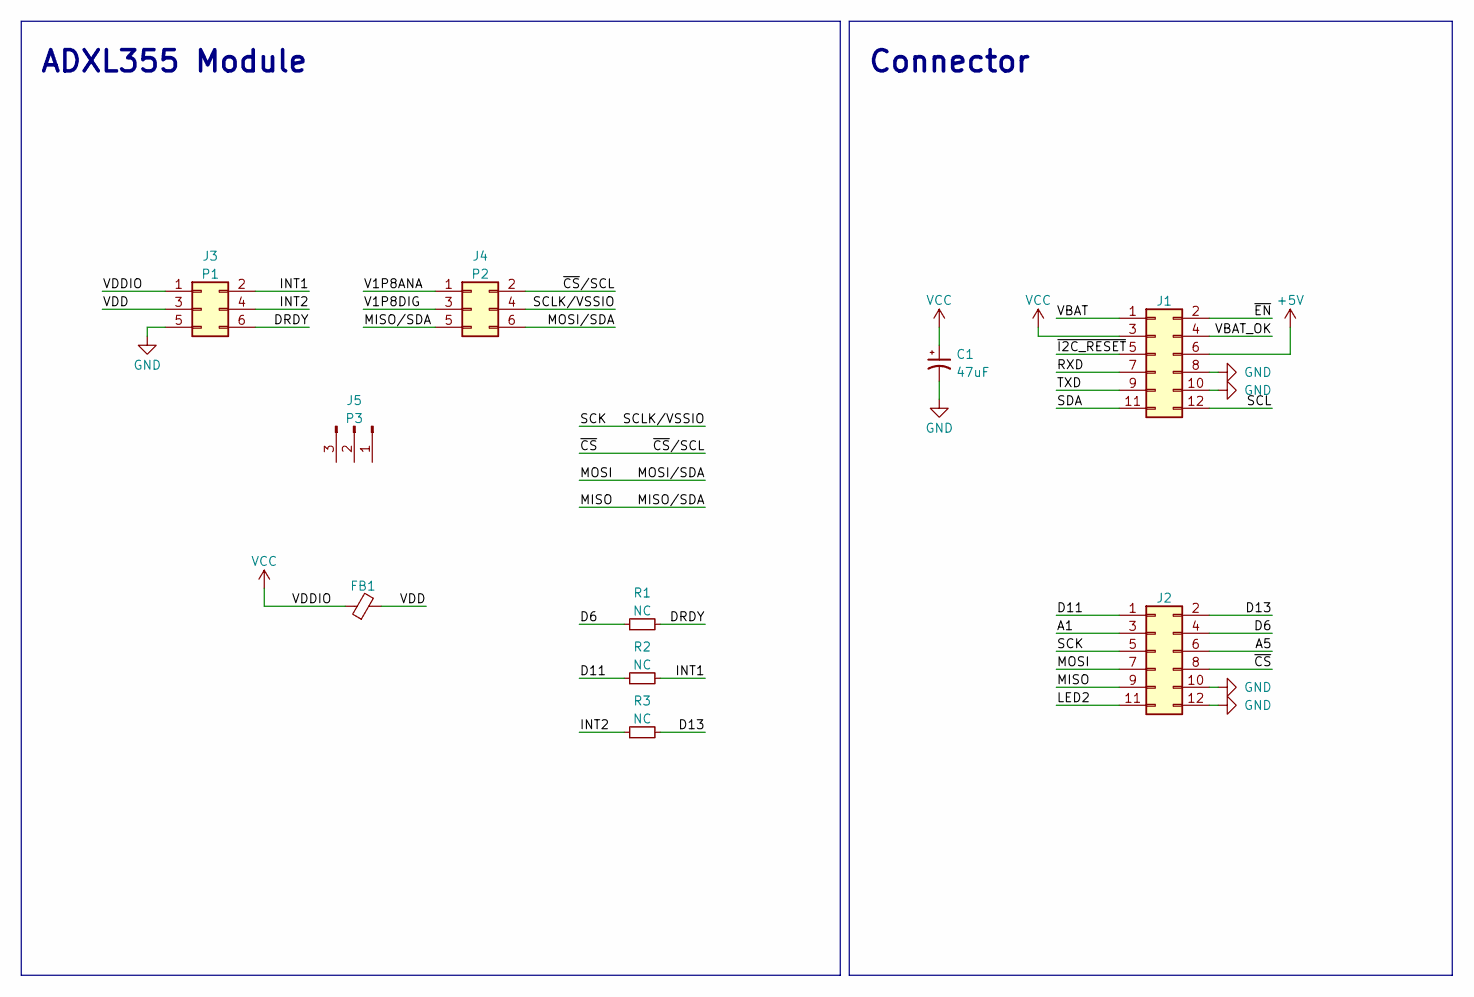
[picture p28: schematic ADXL355.kicad_sch, HexSense Svalbard - MCU module]

Parts:
C1: 47uF; LED_0805_2012Metric_Pad1.15x1.40mm_HandSolder
FB1: FerriteBead_Small; R_0603_1608Metric_Pad0.98x0.95mm_HandSolder
J1, J2: Conn_02x06_Odd_Even; PinHeader_2x06_P2.54mm_Vertical
J3: P1; PinHeader_2x03_P2.54mm_Vertical
J4: P2; PinHeader_2x03_P2.54mm_Vertical
J5: P3; PinHeader_1x03_P2.54mm_Vertical
R1, R2, R3: NC; R_0805_2012Metric

Connections:
+5V: J1.6
/A1: J2.3
/A5: J2.6
/D6: J2.4, R1.1
/D11: J2.1, R2.1
/D13: J2.2, R3.2
/DRDY: J3.6, R1.2
/INT1: J3.2, R2.2
/INT2: J3.4, R3.1
/LED2: J2.11
/MISO: J2.9, J4.5
/MOSI: J2.7, J4.6
/RXD: J1.7
/SCK: J2.5, J4.4
/SCL: J1.12
/SDA: J1.11
/TXD: J1.9
/V1P8ANA: J4.1
/V1P8DIG: J4.3
/VBAT: J1.1
/VBAT_OK: J1.4
/VDD: FB1.2, J3.3
/~CS: J2.8, J4.2
/~EN: J1.2
/~I2C_RESET: J1.5
GND: C1.2, J1.8, J1.10, J2.10, J2.12, J3.5
VCC: C1.1, FB1.1, J1.3, J3.1

Notes on the sheet:
ADXL355 Module
Connector

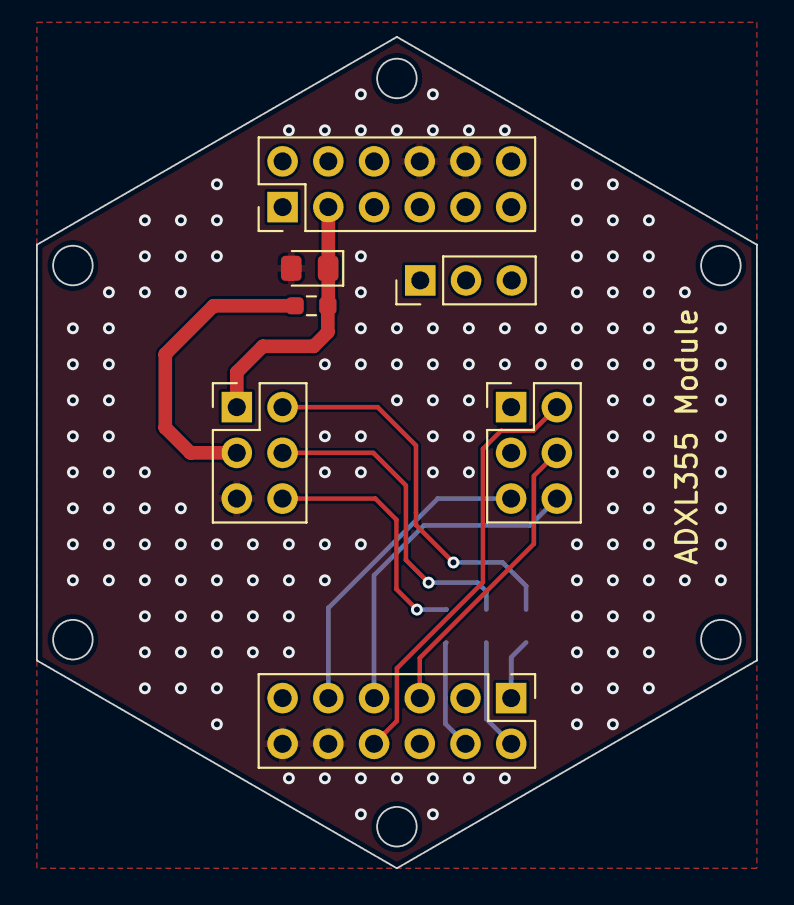
[picture p29: board ADXL355.kicad_pcb from above]

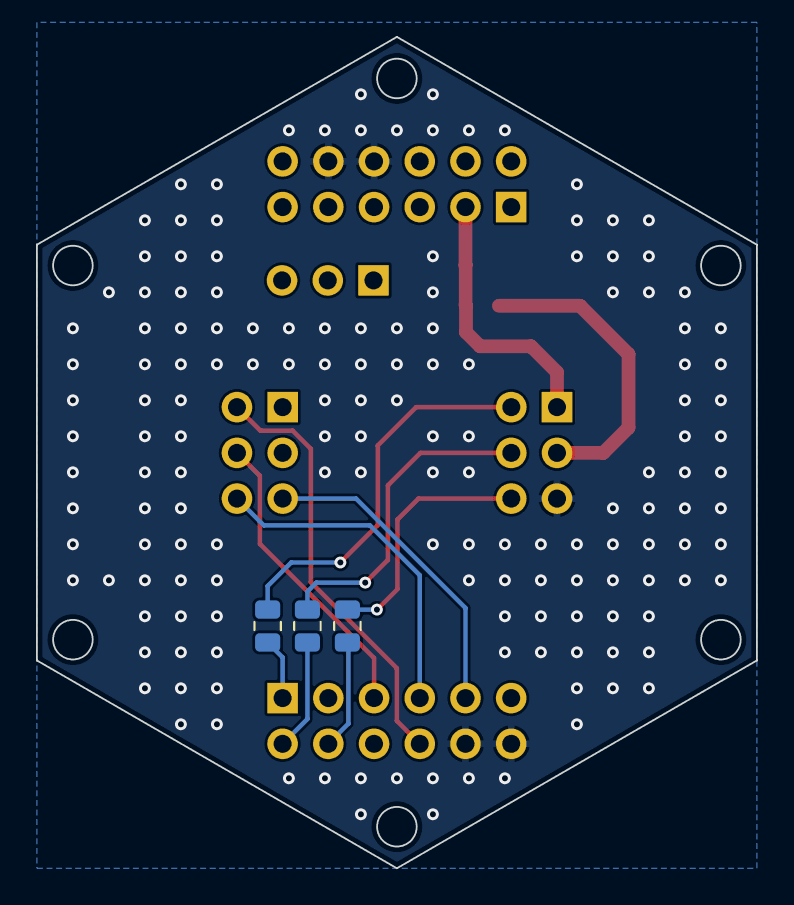
[picture p30: board ADXL355.kicad_pcb from below]

Board: 2 copper layers, 40.0 x 46.2 mm, 10 parts (3 on the bottom side), 13 nets.
