Ironman-007/HexSense_Svalbard/PCB/GEOPHONE_FE/GEOPHONE_FE.kicad_pcb

## KiCad design PCB/GEOPHONE_FE/GEOPHONE_FE.kicad_pcb (2023-05-29)

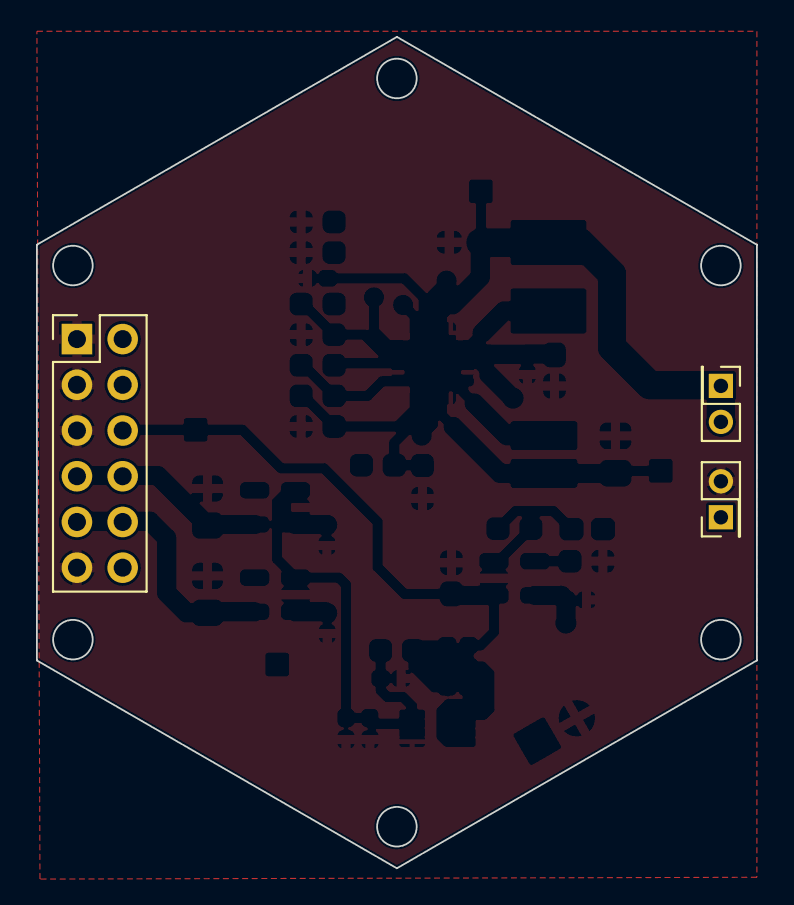
[picture p31: board GEOPHONE_FE.kicad_pcb from above]

Board: 2 copper layers, 40.0 x 46.2 mm, 3 parts (0 on the bottom side), 5 nets, no tracks yet.

Parts:
J2: Conn_02x06_Odd_Even; PinHeader_2x06_P2.54mm_Vertical
J3: Battery; PinHeader_2x01_P2.00mm_Vertical
J4: Solar cell; PinHeader_2x01_P2.00mm_Vertical

Connections:
+1V8: J2.9, J2.10
+3V3: J2.7, J2.8
/SC: J4.1, J4.2
/VBAT: J2.6, J3.1
GND: J2.1, J2.3, J2.5, J2.11, J3.2
