Ironman-007/HexSense_Svalbard/Firmware/nRF52840_FRAM_tst/src/main.cpp

#include <Arduino.h>
#include <SPI.h>
#include <Wire.h>
#include "Adafruit_FRAM_SPI.h"

/* Example code to interrogate Adafruit SPI FRAM breakout for address size and storage capacity */

/* NOTE: This sketch will overwrite data already on the FRAM breakout */

uint8_t FRAM_CS = PIN_SERIAL1_RX;
Adafruit_FRAM_SPI fram = Adafruit_FRAM_SPI(FRAM_CS);  // use hardware SPI

uint16_t          addr = 0;

void setup(void) {
  Serial.begin(115200);
  while (!Serial) delay(10);     // will pause Zero, Leonardo, etc until serial console opens
  
  if (fram.begin()) {
    Serial.println("Found SPI FRAM");
  } else {
    Serial.println("No SPI FRAM found ... check your connections\r\n");
    while (1);
  }
  
  // Read the first byte
  uint8_t test = fram.read8(0x0);
  Serial.print("Restarted "); Serial.print(test); Serial.println(" times");

  // Test write ++
  fram.writeEnable(true);
  fram.write8(0x0, test+1);
  fram.writeEnable(false);

  fram.writeEnable(true);
  fram.write(0x1, (uint8_t *)"FTW!", 5);
  fram.writeEnable(false);

  // dump the entire 8K of memory!
  uint8_t value;
  for (uint16_t a = 0; a < 8192; a++) {
    value = fram.read8(a);
    if ((a % 32) == 0) {
      Serial.print("\n 0x"); Serial.print(a, HEX); Serial.print(": ");
    }
    Serial.print("0x"); 
    if (value < 0x1) 
      Serial.print('0');
    Serial.print(value, HEX); Serial.print(" ");
  }
}

void loop(void) {

}
